carlkesselman/XLeRobot/config/RUNNING.md

# Running the robot

Day-to-day operation. `ORIN-SETUP.md` is the one-time bring-up; this is what
you do every session.

---

## At a glance

| where | what | why first |
|---|---|---|
| **Mac** | `./config/viewer.sh` | the cart connects *out* to it; nothing listening means it back-pressures into the control loop |
| **rosie** | `./config/operator-leader-host.sh` | the cart waits 10 s for the first action and gives up |
| **elroy** | `./config/cart-teleop.sh` or `cart-record.sh` | needs both of the above |

All over SSH. Neither robot machine needs a screen — the Mac is the screen,
and the video originates on the cart, not the Pi.

---

## 1. Mac — the viewer (only if you want video)

```bash
cd ~/GitHub/Robots/XLeRobot        # the Mac's checkout; elroy and rosie
./config/viewer.sh                 # use ~/GitHub/XLeRobot
```

That reads the version out of `uv.lock` and launches it. Don't type the
version yourself and don't leave it off: `uvx --from rerun-sdk rerun` means
"PyPI's latest today", elroy means "whatever the lock says", and those are
currently five minor releases apart. A viewer and an SDK are two halves of
one rerun release — mismatch them and the window opens, sits on the welcome
screen, and never tells you why.

<details>
<summary>the equivalent by hand</summary>

```bash
uvx --from rerun-sdk==0.33.1 rerun     # version must match uv.lock
```

**No flags.** That one process is both the window and the listener — it
opens the viewer *and* serves gRPC on `0.0.0.0:9876`, which is what elroy
connects out to. There is no separate server to start, and `--port 9876`
is just the default spelled out.

It prints this on startup, and it is **not** a sign anything is wrong:

```
INFO re_grpc_server: Listening for gRPC connections on 0.0.0.0:9876.
Connect by running `rerun --connect rerun+http://127.0.0.1:9876/proxy`
```

Every mode that starts the server prints it, window or no window. It is
advice for the case where you *also* want a second viewer attached from
somewhere else — not an instruction to go and run something. Ignore it.
(`--serve-grpc` is the genuinely headless mode. You will not need it.)

</details>

**If the window opens but stays on the welcome screen**, the stream is not
arriving. Prove the link on its own, from elroy, with no robot in the way:

```bash
./config/video.sh synthetic          # moving test pattern, 3 fake cameras
```

Nothing appears? Then it is the link, in this order:

1. the viewer's version matches `uv.lock` — use `./config/viewer.sh`
2. the viewer is running as plain `rerun`, not `--serve-grpc`
3. `nc -z -v 192.168.1.52 9876` from elroy answers
4. the Mac's firewall — System Settings → Network → Firewall. It blocks
   incoming connections to unknown binaries by default, and a
   `uvx`-launched rerun looks like a new binary whenever the cache moves.
   Either allow it when macOS asks, or turn the firewall off long enough
   to find out whether that is the answer.

Skip this whole step if you don't need to see what the robot sees.

---

## 2. rosie — the leaders

```bash
tmux new -s leaders                 # see below
cd ~/GitHub/XLeRobot
./config/operator-leader-host.sh
```

Expect:

```
serving: tcp://192.168.1.100:5557
         remap_arm_prefix: true
         emit_head: true
         emit_base: true
         ^ these must match the cart's config. A mismatch is silent.
Publishing on tcp://*:5557 at 60 Hz
17 action keys:
  ...
```

**17 keys** means arms, head and base. 12 means the head and base are
switched off and the gamepad will do nothing.

**Use tmux.** An SSH drop kills this process, and mid-recording that means
the cart's link stalls, the base zeroes and you lose the take. `Ctrl-B` then
`D` detaches; `tmux attach -t leaders` comes back.

---

## 3. elroy — the robot

```bash
cd ~/GitHub/XLeRobot
./config/cart-teleop.sh            # drive, record nothing; video to the Mac if viewer.sh is running
./config/cart-teleop.sh --watch    # video, warn if the viewer is not up
./config/cart-teleop.sh --no-watch # no video
```

Press ENTER at the calibration prompt to restore from file.

**Hold the leaders roughly where the followers are sitting before you
start.** The first action moves the followers to meet them.

**Cart on blocks** unless you mean it — the base is live.

### Which base

The cart runs in three configurations. One field in the robot config picks
it, and `BASE=` on any cart script overrides it for a run — no yaml edit:

| | `BASE=` | what it means |
|---|---|---|
| two brushless wheels on the ODESC (default) | `odrive` | wheels over USB; bus 2 is the right arm only; features `x.vel`, `theta.vel` |
| the stock three servo omniwheels | `omniwheels` | ids 7–9 on bus 2; features `x.vel`, `y.vel`, `theta.vel` |
| arms and head only | `none` | no wheel ids, no `.vel` features; base commands from the operator are ignored (one warning) |

```bash
BASE=none ./config/cart-teleop.sh                # arms and head, cart parked
BASE=omniwheels ./config/cart-selftest.sh --base
```

The dataset's columns follow the choice, so episodes recorded under
different bases are different datasets. On the operator side `emit_y_vel`
should be true only with `omniwheels`; the others drop a `y.vel` with one
warning rather than fail.

### Recording

```bash
./config/cart-record.sh carlkesselman/<name> "<task description>" \
  --dataset.num_episodes=5 --dataset.episode_time_s=30
```

Episode keys are read by whichever process owns the TTY: right arrow ends an
episode, left re-records it, escape stops. Run it from an SSH session you
are attached to, inside tmux if you like — lerobot falls back to a terminal
listener when pynput cannot capture, so an SSH TTY works.

The script records **locally** (`PUSH_TO_HUB=true` to upload; `hf auth login`
once first), encodes **h264** (`VCODEC=` to change; lerobot's AV1 default is
slow on the Orin), writes frames in 2 processes, and turns lerobot's spoken
prompts off. Datasets land in `~/.cache/huggingface/lerobot/<repo_id>_YYYYMMDD_HHMMSS` - lerobot stamps every new one - and the script prints the path at the end. **Escape saves the current episode and stops; Ctrl-C loses it.** The
Jetson needs the `dataset` extra, which `./config/sync.sh` adds and checks.

The shared yaml's top-level `fps:` is a teleop field that `lerobot-record`
rejects; the script records from a copy without it, so the yaml stays
shared. The head camera is RGB now, like the wrists (it was BGR).

### Training

```bash
./config/cart-train.sh carlkesselman/<name>
```

From elroy, where the recording is. A plain name picks the newest
`<name>_<date>_<time>`; lerobot pushes it to a **private** Hub repo if it is
not there yet, then submits ACT to Hugging Face Jobs (`FLAVOR=a10g-small`,
`STEPS=100000`). The model lands at `carlkesselman/act_<name>`. Needs
`hf auth login` and an HF account that can run Jobs. Run it in tmux: the log
streams here, and an SSH drop ends the stream but not the job
(`hf jobs logs <id>` picks it up again).

### Running a policy

```bash
BASE=none ./config/cart-eval.sh carlkesselman/act_<name> "<task description>"
BASE=none ./config/cart-eval.sh --record carlkesselman/act_<name> "<task description>"
```

**The policy drives the arms.** Use the same `BASE=` and the same task text
as the recording. The first form runs for 60 s (`DURATION=`) and records
nothing. `--record` runs 10 scored episodes into
`carlkesselman/eval_act_<name>_<date>_<time>`, with the same episode keys as
recording. rosie is not needed: between episodes the arms go back to their
startup pose. `--leaders` connects to rosie instead, so the operator can
reset the arms between episodes.

---

## Controls

8BitDo SF30 Pro, wired, in its PlayStation-compatible mode.

| control | does |
|---|---|
| leader arms | the follower arms |
| D-pad | head pan / tilt |
| left stick Y | base forward/back (no strafe: the ODrive base is a differential drive) |
| right stick X | base turn |
| R1 / L2 | base speed up / down |

If the pad power-cycles into a different input mode every one of those
becomes wrong at once, and the symptom is a cart that drives sideways rather
than any error. Re-probe:

```bash
uv run python -m \
  lerobot_teleoperator_xlerobot_leader_gamepad.probe_gamepad
```

---

## What good looks like

From the cadence summary printed on Ctrl-C:

```
effective cadence  29.5 Hz    (target 30 - the camera frame rate is the ceiling)
observe            ~28 ms     95% of all work; it is waiting for frames, not computing
teleop             0.05 ms    the whole network leader
send               ~1.5 ms
pacing headroom    4.3 ms     without video, 1.6 ms with
```

**Headroom is the number to watch.** Near zero means the loop is saturated
and has nothing left to absorb a hiccup. Video costs about 2.7 ms of it.

30 Hz is the ceiling, not a disappointment: `observe` blocks until the next
camera frame, and the cameras are 30 fps. A 4x reduction in pixels bought
only 13% off it, which is how we know it is latency-bound rather than
pixel-bound.

---

## When it goes wrong

| symptom | cause |
|---|---|
| **Arms do not move, loop runs at rate, no errors** | `remap_arm_prefix` disagrees across the link. `bi_so_follower` strips `left_`; `xlerobot` filters on `left_arm_`. |
| **Gamepad does nothing** | `emit_head`/`emit_base` false on rosie. Check the 17-key count. |
| `No action from the leader host ... within 10.0s` | leader host not running, or the wrong IP in `cart-remote.yaml` |
| `Leader link stalled` | wifi. Arms hold, base zeroes. Occasional is normal; constant is not. |
| `Failed to write 'Torque_Enable' on id_=N` | a dropped packet; `configure()` retries three times now. If it persists, run `./config/servo.sh power` before suspecting a servo. |
| `Failed to open OpenCVCamera(/dev/cam_left)` | usually a stale process: `pkill -f lerobot-teleoperate`. If the symlink is missing instead, `sudo udevadm trigger --action=add --subsystem-match=video4linux`. |
| **Script prints the header and exits silently** | `set -e` on a non-zero return. Shout about it; it is a bug. |
| **A fresh calibration starts** | you are on the arms-only config without one. It should refuse now — if it does not, Ctrl-C before the range-recording phase or you lose `robots/xlerobot/xlerobot.json`. |
| **CPU torch on elroy** | a bare `uv sync`. Use `./config/sync.sh`, which picks the right extras per machine. |
| **`Leader link stalled ... base stopped, arms holding` about once a second, only with `--watch`** | the cart's TCP ACKs to rosie queued behind video on the wifi uplink. Both sockets now set `TOS 0xC0` (voice queue) — see `link.py`. If it persists: `iperf3 -c 192.168.1.52` from elroy for the real uplink goodput, and cap the send buffer so back-pressure reaches rerun instead of the kernel: `sudo sysctl -w net.ipv4.tcp_wmem='4096 16384 262144'` (not persistent; put it in `/etc/sysctl.d/` if it helps). The stall line now prints sequence gaps, and recovery prints apparent one-way delay. |
| **Video many seconds behind on every camera, and `Leader link stalled` every second or so** | wifi power saving on elroy or rosie. `iw dev <iface> get power_save` (`/usr/sbin/iw` on rosie); if `on`, see "Wifi power saving off" in `ORIN-SETUP.md`. On elroy also `cat /sys/module/rtl8822ce/parameters/rtw_power_mgnt` - the driver's own power saving, which `iw` does not show; it must be `0`. Then `iperf3 -c 192.168.1.52` from elroy, with `iperf3 -s` on the Mac, for what the link really carries. |
| **Picture seconds behind, loop healthy** | same queue as the row above. Frames are now stamped with capture time, so the lag shows as an offset in the viewer's timeline rather than looking fresh. `LEROBOT_RERUN_JPEG_QUALITY` (default 70) and `LEROBOT_RERUN_IMAGE_FPS` (default 10) are the two levers; `tcp_wmem` above is the third. |
| **Head jerky, arms smooth** | `head_goal_velocity` / `head_acceleration` in the robot config give the head servos a motion profile; defaults 600 / 40. Lower acceleration = smoother, slower to start. |
| **Viewer draws the grid, then stops responding as soon as frames arrive** | `rerun_visualization.py` logging images with `static=True`. Fixed here — but it is upstream's file, so a merge from upstream will bring it back. One 160x120 frame a second is enough to trigger it, so do not read it as a bandwidth problem. `./config/video.sh synthetic --no-static` is the control. |

---

## Diagnostics

Grouped by what they look at. Each multi-command script prints its own
list with `--help`.

| | |
|---|---|
| **the cart** | |
| `./config/cart-selftest.sh` | the cart alone: rate, joint values, a frame per camera. `--head --arms --base` to move things; `BASE=none` without wheels. |
| **servos** - `./config/servo.sh` | |
| `servo.sh scan` | which ids answer on each bus, at which baud rate |
| `servo.sh power` | voltage, temperature and load per servo, torque on one at a time |
| `servo.sh regs [--bus 1]` | every config and status register side by side; flags the servo that differs or runs hot. For one that answers a scan but will not move. Read-only. |
| `servo.sh set-id --bus N --id M [--port ...]` | give a replacement servo its id. It must be the only servo on that bus board (it refuses otherwise); any board works, rosie's included. |
| `servo.sh recal <joint>` | recalibrate one joint after a swap (homing offset + range), leaving the other thirteen. Backs up the calibration file first. |
| **cameras and video** - `./config/video.sh` | |
| `video.sh probe /dev/cam_left [--buffersize 2]` | how many stale frames the driver hands back after a pause |
| `video.sh view` | the real cameras to the viewer, no motor bus touched (arms may be off). Loop rate and display cost, PASS/FAIL; `--help` for the glass-to-glass lag test with `python3 config/ms_clock.py` on the Mac. |
| `video.sh synthetic` | a generated feed to the viewer: the network and viewer with the cameras taken out |
| `./config/viewer.sh` | the rerun viewer, at the version uv.lock says. On the Mac. |
| **leader link** - `./config/leader-link.sh` | |
| `leader-link.sh tap` | the leader stream with no robot: which keys ever changed |
| `leader-link.sh soak [--minutes 5]` | the link for N minutes, graded: stalls, lost messages, histogram. Run quiet, then with `video.sh synthetic` going; both must PASS. |
| **data** | |
| `./config/dataset-check.sh <repo_id>` | read a recording back: frames, features, a decoded frame per camera as PNG, video files. Picks the newest `<repo_id>_<date>_<time>`. |
| **base** | |
| `./config/odrive-check.sh` | the ODESC: config vs the bus limits, `--apply` to write them, `--watch` through a power cut. Motor bring-up: `--halls` (pole pairs), `--setup-motors`, `--calibrate` (drill pack, wheels up), `--spin --axis N`. Tuning: `--push` (floor, which limit stops it), `--save-gains`. |
| `./config/base-characterize.sh` | the base from first principles: `blocks` (motor constant, wheel inertia), `floor` (breakaway, cart inertia, friction vs speed), `design` (current limit, gains, feed-forward, limits - with reasons), `step --candidates` (validate through the teleop code path, pick). |
| **environment** | |
| `./config/sync.sh` | sync with the right extras for this machine |

---

## Order matters

Viewer, then leaders, then cart. Each waits on the one before:

- the cart gives up after 10 s with no leader host
- rerun's proxy may not replay what it buffered before a viewer attached
- starting the cart first just means doing it again
