carlkesselman/XLeRobot/hardware/lidar_bracket/ld19_basket_mount_upper.step

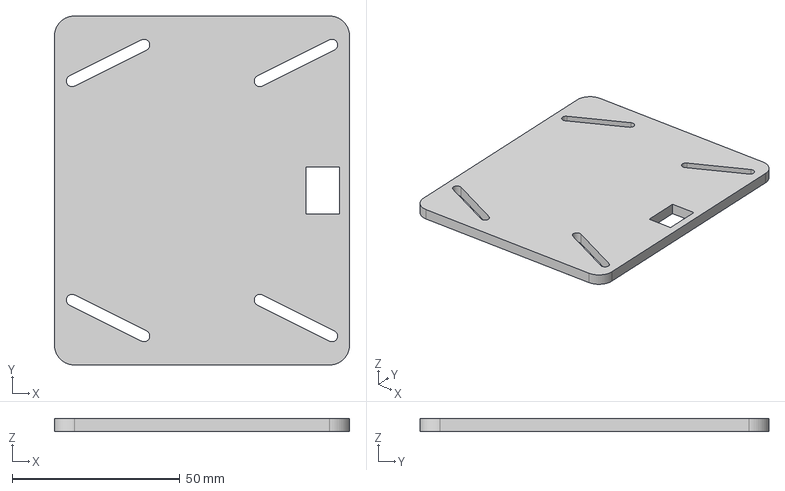
[picture p2: CAD file, 2026-11-03]
hardware/lidar_bracket/ld19_basket_mount_upper.step
88.0 x 104.0 x 4.00 mm
