carlkesselman/XLeRobot/simulation/xlerobot/meshes/xlerobot/assets/Lower_Arm.stl

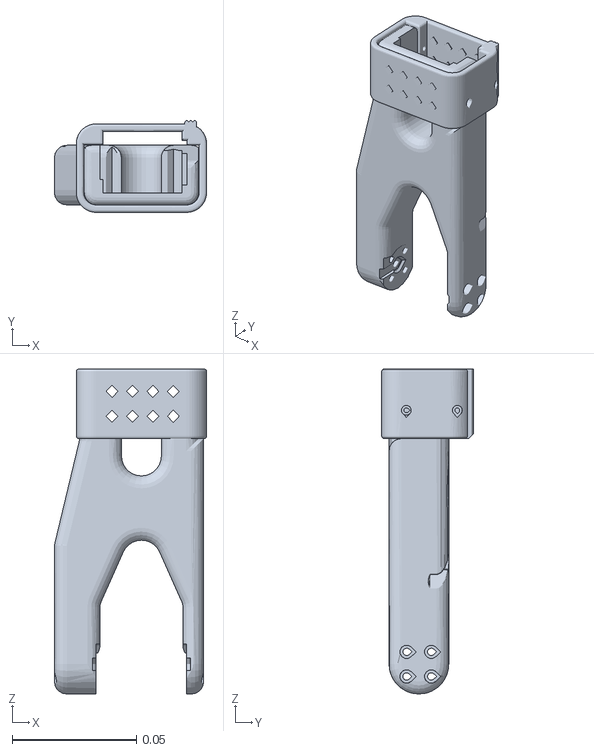
[picture p3: CAD file, 2026-10-06]
simulation/xlerobot/meshes/xlerobot/assets/Lower_Arm.stl
0.0612 x 0.0369 x 0.131
