carlkesselman/XLeRobot/hardware/lidar_bracket/ld19_basket_mount_lower.step

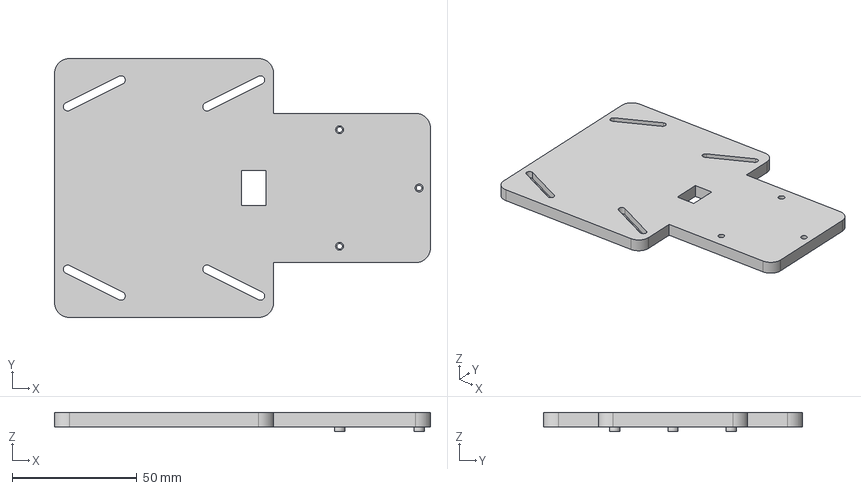
[picture p4: CAD file, 2026-11-03]
hardware/lidar_bracket/ld19_basket_mount_lower.step
151.0 x 104.0 x 7.80 mm
