carlkesselman/XLeRobot/simulation/xlerobot/meshes/xlerobot/assets/topbase2.stl

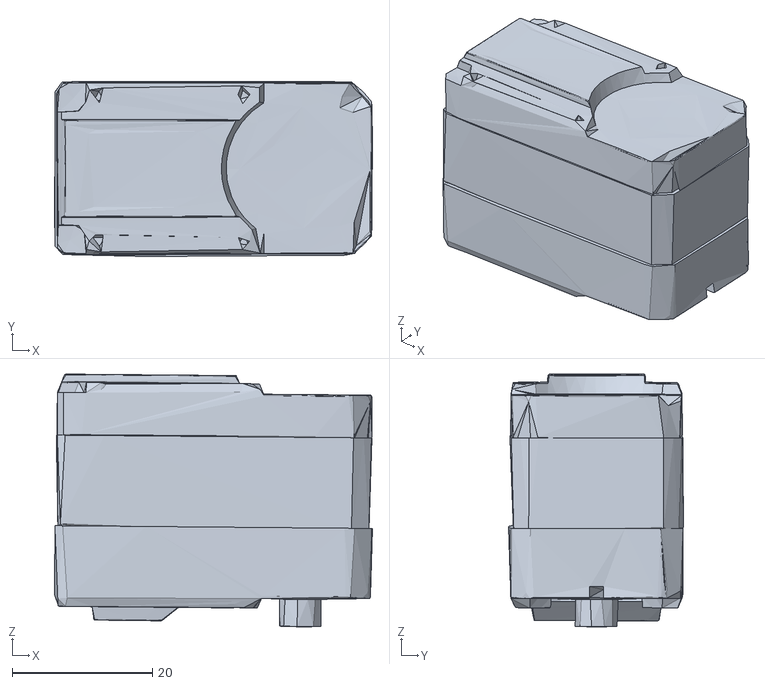
[picture p5: CAD file, 2026-10-06]
simulation/xlerobot/meshes/xlerobot/assets/topbase2.stl
45.3 x 24.9 x 36.0
