carlkesselman/XLeRobot/simulation/xlerobot/meshes/xlerobot/assets/Fixed_Jaw.stl

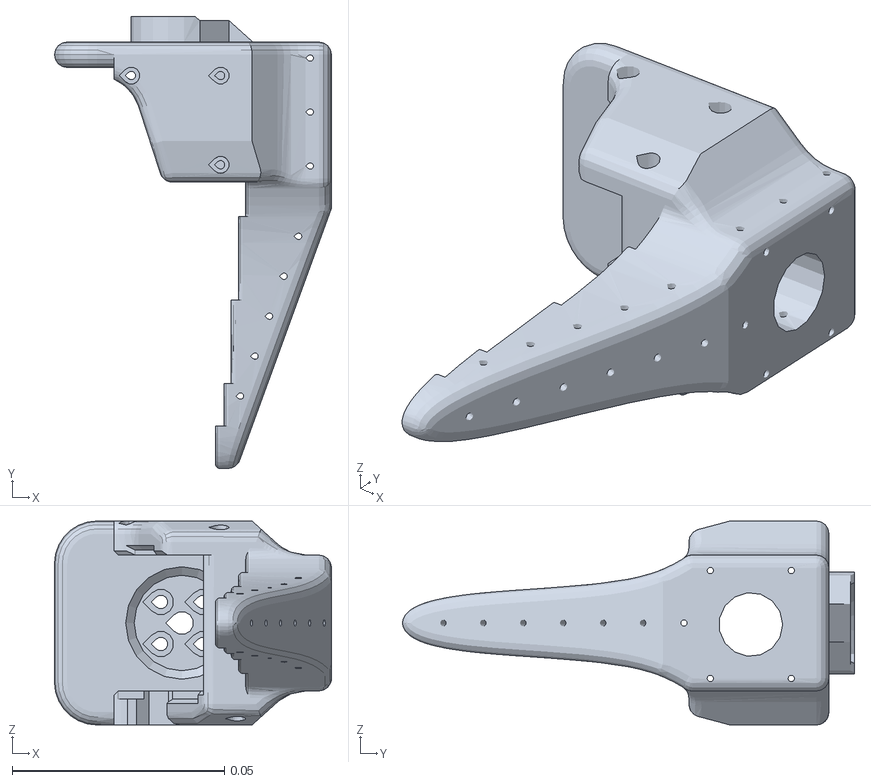
[picture p6: CAD file, 2026-10-06]
simulation/xlerobot/meshes/xlerobot/assets/Fixed_Jaw.stl
0.0652 x 0.106 x 0.048
