carlkesselman/XLeRobot/simulation/xlerobot/meshes/xlerobot/assets/Upper_Arm_Motor.stl

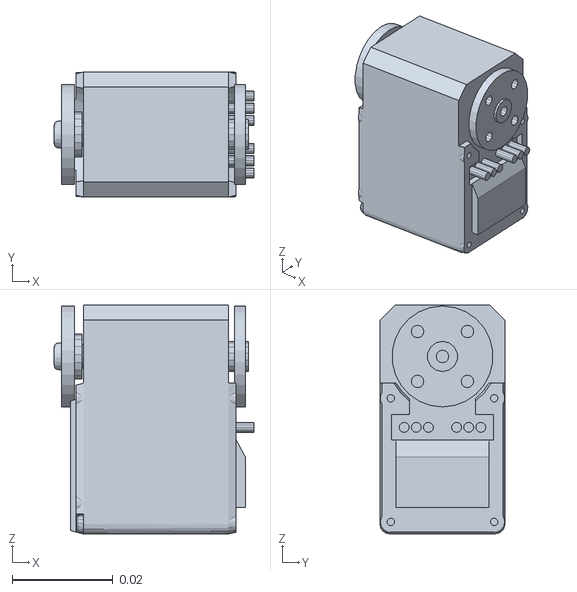
[picture p7: CAD file, 2026-10-06]
simulation/xlerobot/meshes/xlerobot/assets/Upper_Arm_Motor.stl
0.0396 x 0.0248 x 0.0454
