carlkesselman/XLeRobot/simulation/xlerobot/meshes/xlerobot/assets/raskogwheel1.stl

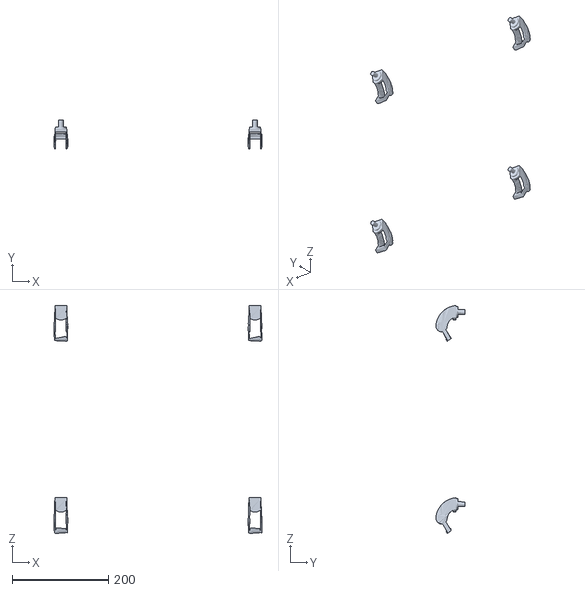
[picture p8: CAD file, 2026-10-06]
simulation/xlerobot/meshes/xlerobot/assets/raskogwheel1.stl
432.7 x 61.2 x 474.6
