carlkesselman/XLeRobot/simulation/xlerobot/meshes/xlerobot/assets/XLeRobot_camera1.stl

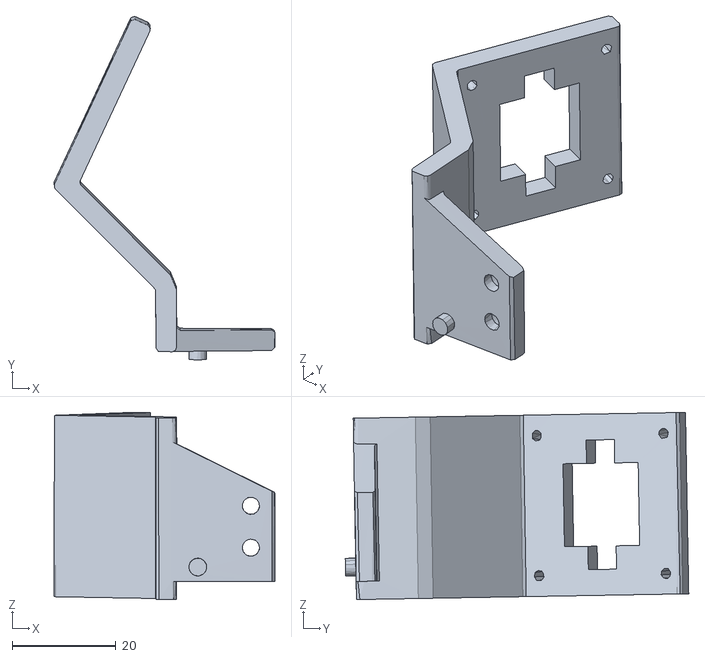
[picture p9: CAD file, 2026-10-06]
simulation/xlerobot/meshes/xlerobot/assets/XLeRobot_camera1.stl
42.6 x 66.3 x 36.1
