carlkesselman/XLeRobot/simulation/xlerobot/meshes/xlerobot/assets/Moving_Jaw.stl

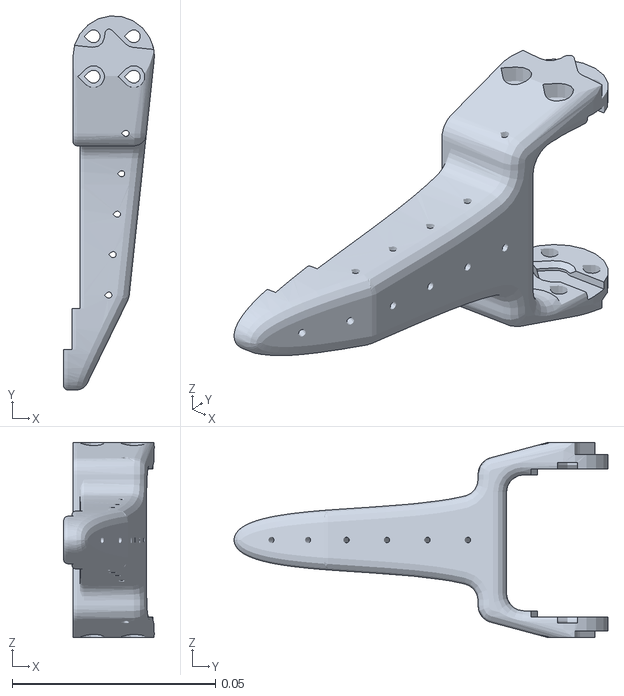
[picture p10: CAD file, 2026-10-06]
simulation/xlerobot/meshes/xlerobot/assets/Moving_Jaw.stl
0.0223 x 0.092 x 0.048
