carlkesselman/XLeRobot/simulation/xlerobot/meshes/xlerobot/assets/raskogwheel2.stl

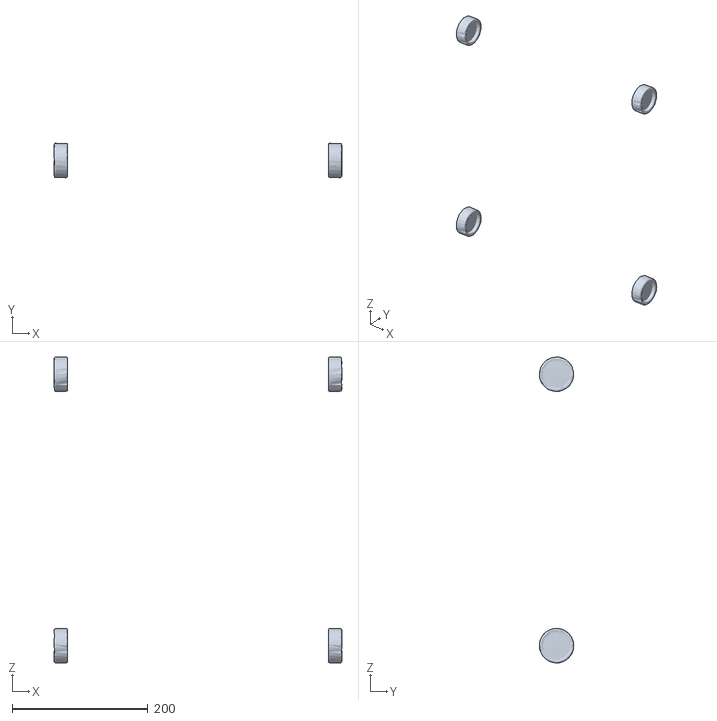
[picture p11: CAD file, 2026-10-06]
simulation/xlerobot/meshes/xlerobot/assets/raskogwheel2.stl
424.1 x 50.9 x 450.9
