carlkesselman/XLeRobot/simulation/xlerobot/meshes/xlerobot/assets/Wrist_Pitch_Roll_Motor.stl

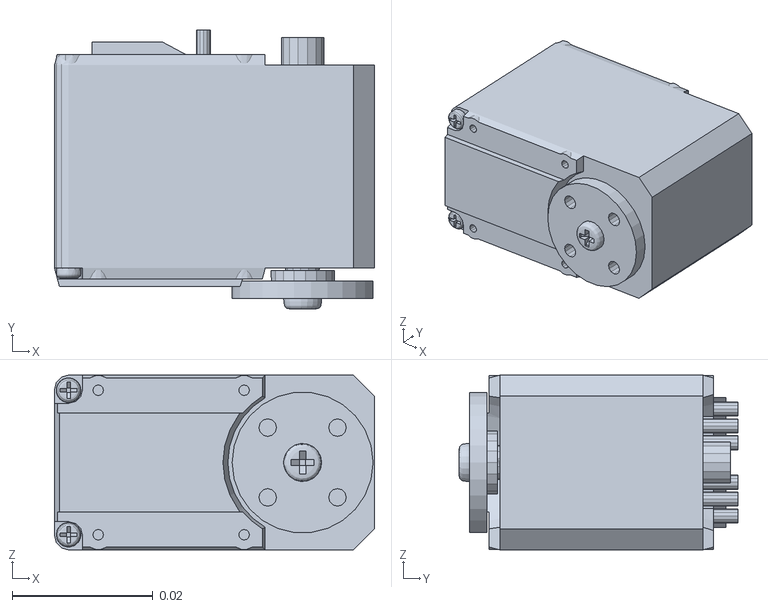
[picture p12: CAD file, 2026-10-06]
simulation/xlerobot/meshes/xlerobot/assets/Wrist_Pitch_Roll_Motor.stl
0.0454 x 0.0396 x 0.0248
