carlkesselman/XLeRobot/simulation/xlerobot/meshes/xlerobot/assets/tophead6.stl

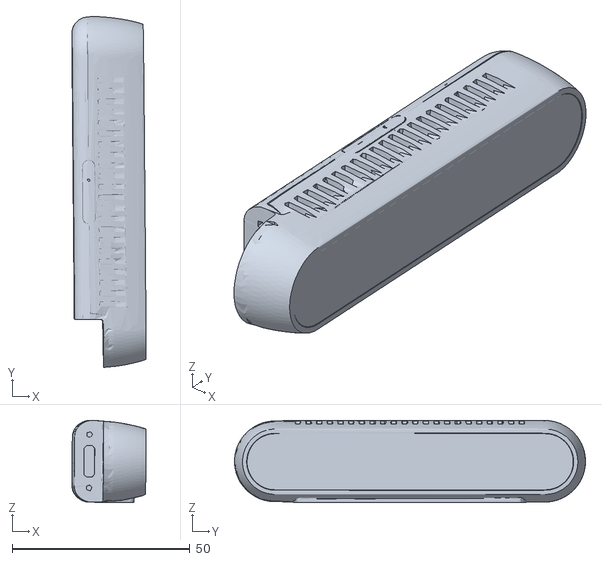
[picture p13: CAD file, 2026-10-06]
simulation/xlerobot/meshes/xlerobot/assets/tophead6.stl
20.9 x 98.8 x 23.1
