carlkesselman/XLeRobot/simulation/xlerobot/meshes/xlerobot/assets/Wrist_Pitch_Roll.stl

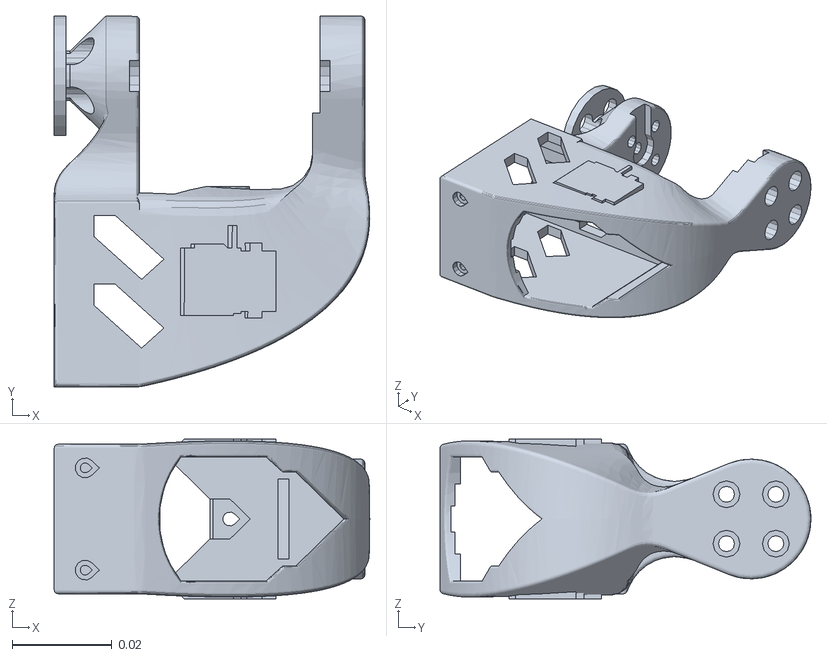
[picture p14: CAD file, 2026-10-06]
simulation/xlerobot/meshes/xlerobot/assets/Wrist_Pitch_Roll.stl
0.0633 x 0.0744 x 0.032
