carlkesselman/XLeRobot/simulation/xlerobot/meshes/xlerobot/assets/topbase1.stl

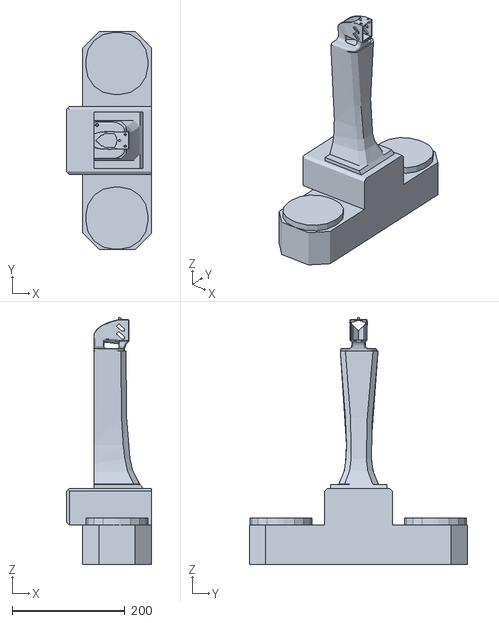
[picture p15: CAD file, 2026-10-06]
simulation/xlerobot/meshes/xlerobot/assets/topbase1.stl
150.4 x 386.3 x 437.4
