carlkesselman/XLeRobot/simulation/xlerobot/meshes/xlerobot/assets/Fixed_Jaw_part1.ply.convex.stl

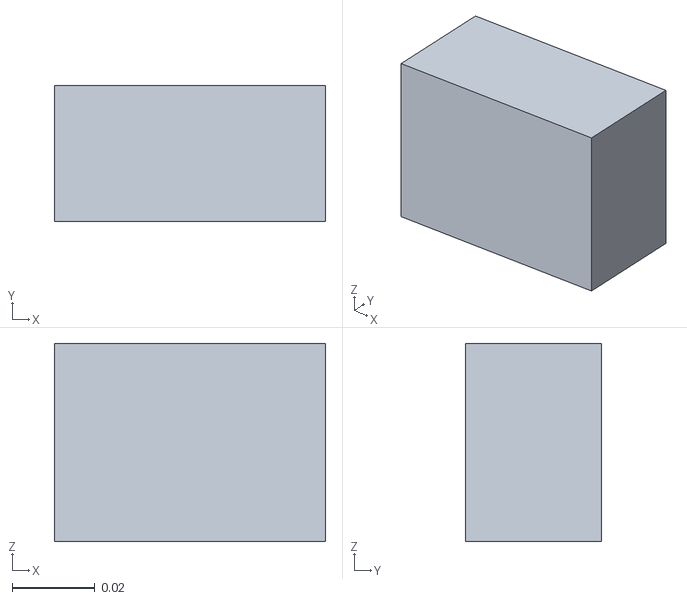
[picture p16: CAD file, 2026-10-06]
simulation/xlerobot/meshes/xlerobot/assets/Fixed_Jaw_part1.ply.convex.stl
0.0656 x 0.0328 x 0.048
