carlkesselman/XLeRobot/simulation/xlerobot/meshes/xlerobot/assets/XLeRobot_camera2.stl

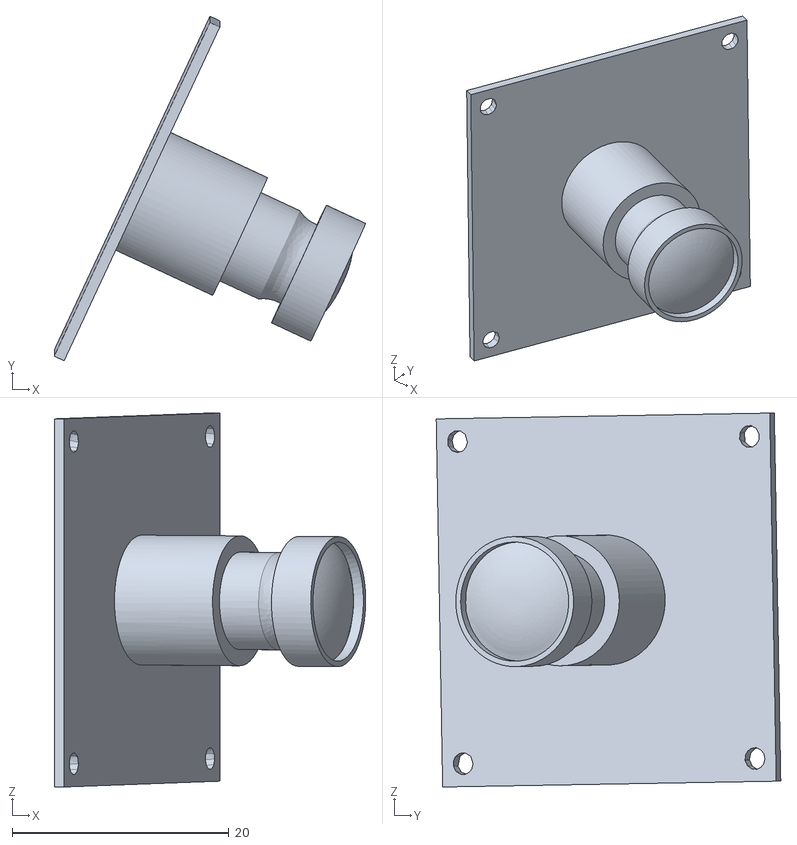
[picture p17: CAD file, 2026-10-06]
simulation/xlerobot/meshes/xlerobot/assets/XLeRobot_camera2.stl
28.8 x 31.8 x 34.5
