carlkesselman/XLeRobot/simulation/xlerobot/meshes/xlerobot/assets/Upper_Arm.stl

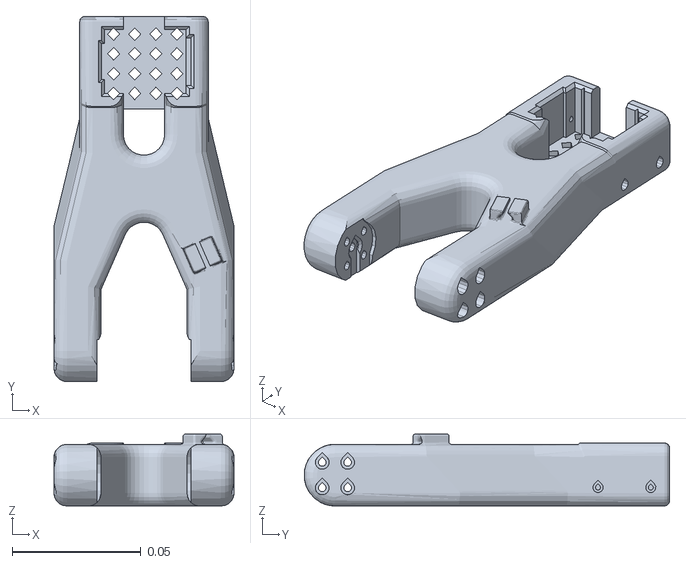
[picture p18: CAD file, 2026-10-06]
simulation/xlerobot/meshes/xlerobot/assets/Upper_Arm.stl
0.07 x 0.142 x 0.028
