carlkesselman/XLeRobot/simulation/xlerobot/meshes/xlerobot/assets/Fixed_Jaw_part2.ply.convex.stl

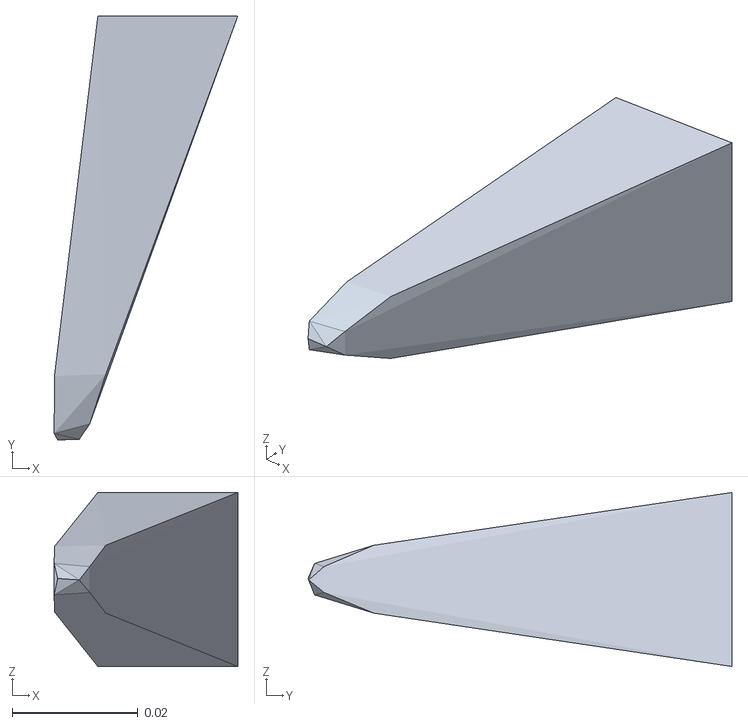
[picture p19: CAD file, 2026-10-06]
simulation/xlerobot/meshes/xlerobot/assets/Fixed_Jaw_part2.ply.convex.stl
0.0292 x 0.0675 x 0.0277
