carlkesselman/XLeRobot/simulation/xlerobot/meshes/xlerobot/assets/Moving_Jaw_part1.ply.convex.stl

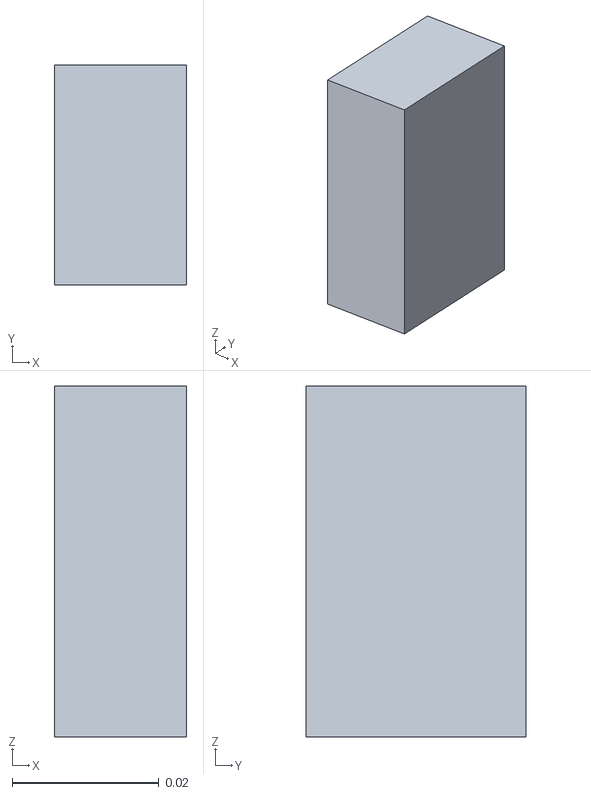
[picture p20: CAD file, 2026-10-06]
simulation/xlerobot/meshes/xlerobot/assets/Moving_Jaw_part1.ply.convex.stl
0.018 x 0.03 x 0.0478
