carlkesselman/XLeRobot/simulation/xlerobot/meshes/xlerobot/assets/tophead5.stl

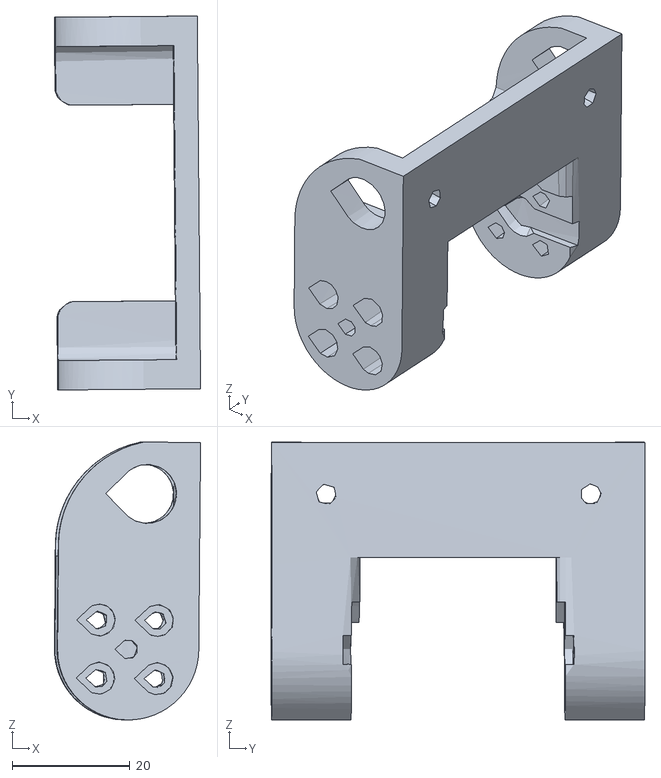
[picture p21: CAD file, 2026-10-06]
simulation/xlerobot/meshes/xlerobot/assets/tophead5.stl
24.9 x 63.6 x 47.3
