carlkesselman/XLeRobot/simulation/xlerobot/meshes/xlerobot/assets/raskogbody.stl

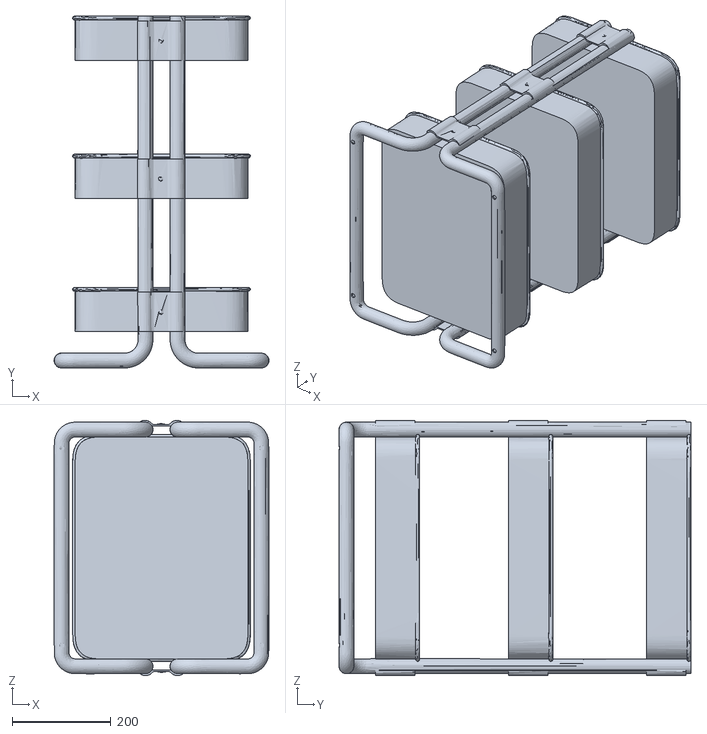
[picture p22: CAD file, 2026-10-06]
simulation/xlerobot/meshes/xlerobot/assets/raskogbody.stl
435.9 x 713.7 x 517.9
