carlkesselman/XLeRobot/simulation/xlerobot/meshes/xlerobot/assets/Base.stl

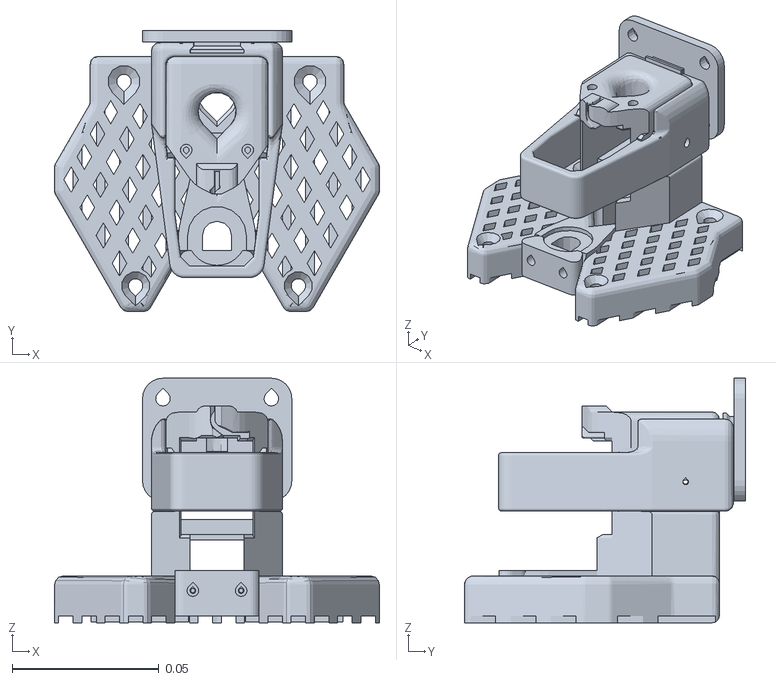
[picture p23: CAD file, 2026-10-06]
simulation/xlerobot/meshes/xlerobot/assets/Base.stl
0.111 x 0.0959 x 0.0835
