carlkesselman/XLeRobot/simulation/xlerobot/meshes/xlerobot/assets/Rotation_Pitch.stl

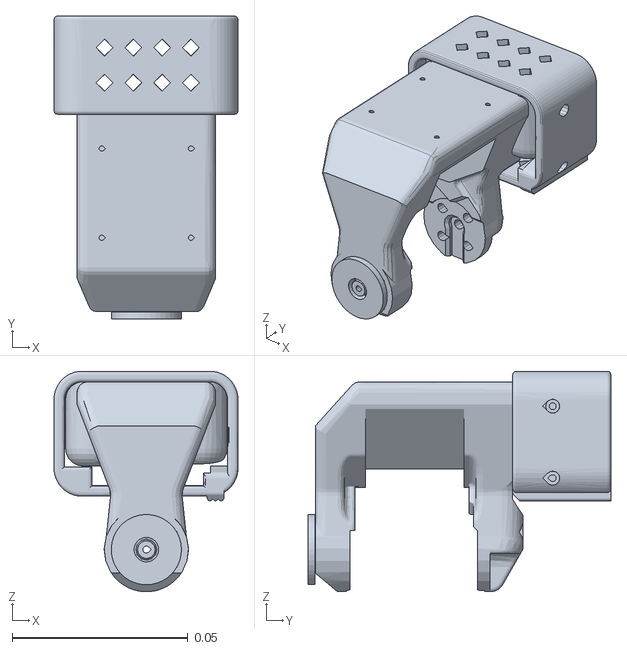
[picture p24: CAD file, 2026-10-06]
simulation/xlerobot/meshes/xlerobot/assets/Rotation_Pitch.stl
0.0524 x 0.0863 x 0.0628
