carlkesselman/XLeRobot/simulation/xlerobot/meshes/xlerobot/assets/Moving_Jaw_part2.ply.convex.stl

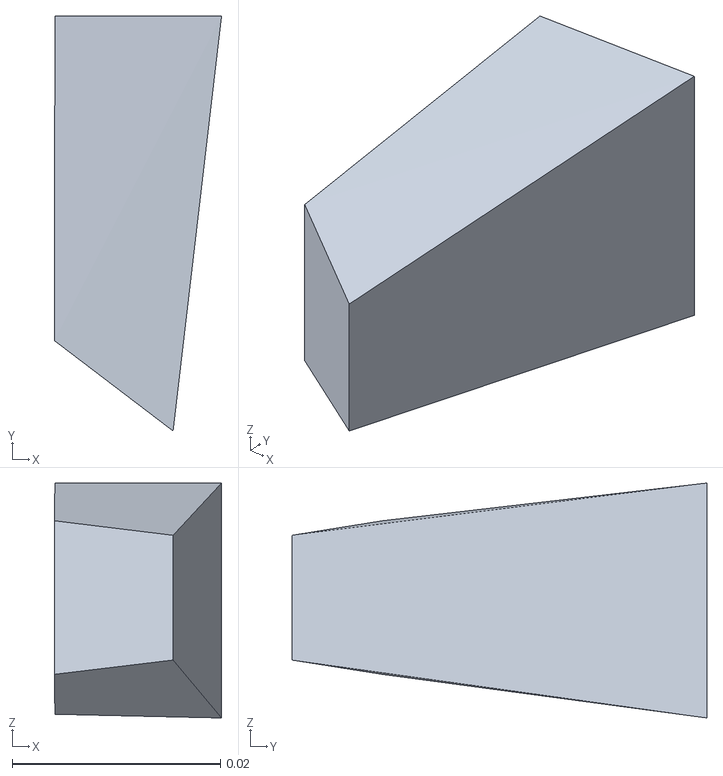
[picture p25: CAD file, 2026-10-06]
simulation/xlerobot/meshes/xlerobot/assets/Moving_Jaw_part2.ply.convex.stl
0.0161 x 0.0399 x 0.0226
