carlkesselman/XLeRobot/simulation/xlerobot/meshes/xlerobot/assets/Moving_Jaw_part3.ply.convex.stl

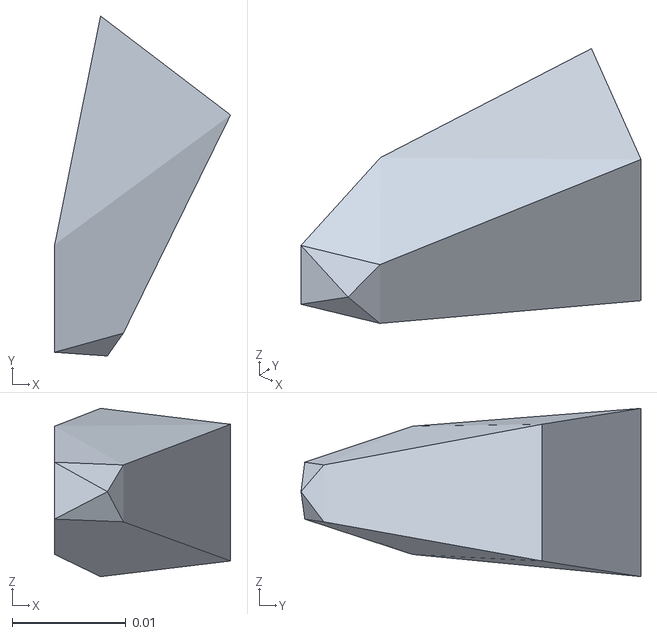
[picture p26: CAD file, 2026-10-06]
simulation/xlerobot/meshes/xlerobot/assets/Moving_Jaw_part3.ply.convex.stl
0.0155 x 0.0298 x 0.0148
