carlkesselman/XLeRobot/simulation/xlerobot/meshes/xlerobot/assets/tophead1.stl

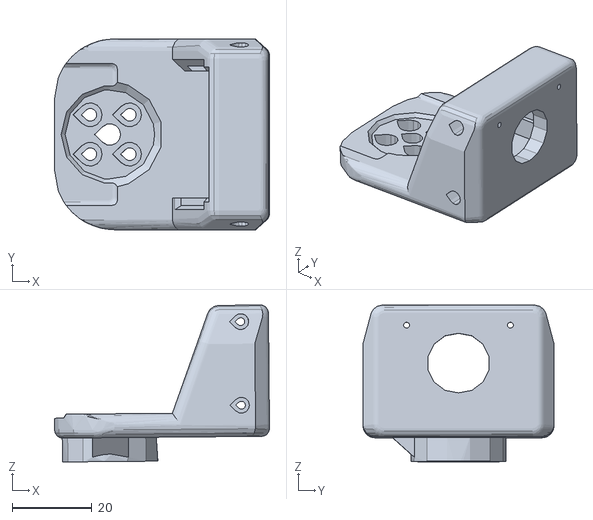
[picture p27: CAD file, 2026-10-06]
simulation/xlerobot/meshes/xlerobot/assets/tophead1.stl
54.0 x 48.0 x 39.4
