carlkesselman/XLeRobot/(list of files, cad)

Other CAD files:
simulation/xlerobot/meshes/xlerobot/assets/Fixed_Jaw_Motor.stl
simulation/xlerobot/meshes/xlerobot/assets/Rotation_Pitch_Motor.stl
simulation/xlerobot/meshes/xlerobot/assets/Lower_Arm_Motor.stl
simulation/xlerobot/meshes/xlerobot/assets/tophead4.stl
simulation/xlerobot/meshes/xlerobot/assets/Base_Motor.stl
hardware/lidar_bracket/ld19_basket_mount_lower.stl
hardware/lidar_bracket/ld19_basket_mount_upper.stl
