carlkesselman/XLeRobot/config/ORIN-SETUP.md

# Bringing up elroy (the Orin) as the cart

One step at a time, each with a check that has to pass before the next.
Everything here runs on the Orin unless a step says otherwise.

The aim of this document is a verified robot on one machine — arms, head,
base and three cameras — with no network, no leader arms and no dataset in
the picture. Those come after.

---

## 0. Find out what hardware you actually have

**Run this where the arms are plugged in right now** — on the Pi, before
moving anything. It is a hardware question, not a machine question, and
knowing the answer changes every later step.

```bash
./config/servo.sh scan
```

It pings every id at every supported baud rate on both buses and maps what
answers onto the xlerobot layout:

```
bus1   1-6 left arm    7-8 head
bus2   1-6 right arm   7-9 base wheels
```

The three outcomes:

- **Arms, head and base all present** → the full `xlerobot` path works.
  Continue through this document as written.
- **Arms only, head missing** → the robot fails on connect: it reads the
  head on the same bus as the left arm, so a missing head servo stops the
  arms too. Wire it before going on. (A missing *base* is fine:
  `BASE=none` runs arms and head alone.)
- **Something at the wrong baud rate** → `lerobot-setup-motors` for those
  servos. lerobot talks at 1000000 and will not find them otherwise.

A whole bus silent is usually the cable or the power. One id silent is
usually that servo or the daisy-chain link into it.

---

## 1. Python 3.12 and the workspace

```bash
git clone -b rosie-config     https://github.com/carlkesselman/XLeRobot.git ~/GitHub/XLeRobot
git clone -b feature/xlerobot https://github.com/carlkesselman/lerobot.git  ~/GitHub/lerobot   # sibling

cd ~/GitHub/XLeRobot            # config/ and the workspace both live here
uv python pin 3.12
./config/sync.sh                # not a bare uv sync - see the script
```

**3.12 exactly.** `pyrealsense2` publishes aarch64 wheels for cp39, cp310
and cp312 only — no cp313, no cp314, and no sdist to build from. lerobot
needs ≥3.12, which leaves one version.

**Sync from XLeRobot, never from lerobot.** XLeRobot is the workspace root
and maps `lerobot` to `../lerobot`; syncing from the lerobot repo prunes
the plugins and `--robot.type=xlerobot` stops resolving.

Check:

```bash
uv run python -c "
from lerobot.robots import make_robot_from_config
from lerobot_robot_xlerobot import XLerobotConfig
print('xlerobot plugin OK')"
```

---

## 2. GPU torch

A plain `uv sync` installs PyPI's aarch64 **CPU** torch. That is wrong for
the machine whose entire reason for being on the cart is the GPU, and
nothing will tell you — teleoperation and recording do not care, inference
does.

**On JetPack 7 the Orin uses the stock upstream CUDA wheels.** NVIDIA
confirmed Orin can take the SBSA package, so the old ritual of hunting
NVIDIA forum wheels is over. Note also that the `jetson-ai-lab.io/jp6/cu126`
index does **not** work on JetPack 7 — people try it and get
"from versions: none".

Check what CUDA you actually have, because the index name has to match:

```bash
/usr/local/cuda/bin/nvcc --version | tail -2     # nvcc is not on PATH by default
nvidia-smi | head -4
```

On elroy that reads CUDA **13.2**, driver 595.78 — hence `cu132`. The
XLeRobot workspace declares that as the `jetson` extra, so:

```bash
cd ~/GitHub/XLeRobot
uv sync --extra jetson
```

**Use `./config/sync.sh` instead of `uv sync`.** It detects a Jetson and
adds the extra for you, so the question stops existing:

```bash
./config/sync.sh
```

`uv sync` makes the environment match the lock, so a bare sync on this
machine silently replaces CUDA torch with the CPU build — no error, nothing
downstream fails, and you find out weeks later when inference is slow.

That cannot be prevented in configuration. uv has no environment variable
for extras (`UV_NO_DEFAULT_GROUPS` exists; `UV_EXTRA` does not), and
`tool.uv.default-groups` lives in `pyproject.toml`, which rosie shares — and
the cu132 source marker is `linux aarch64`, which matches rosie too, so
making it a default would push CUDA torch onto the Pi.

So instead: one command that is always right, plus a check in `_common.sh`
that every cart script runs. If a bare `uv sync` ever does happen, the next
`cart-teleop.sh`, `cart-record.sh` or `cart-selftest.sh` says so in a banner
rather than carrying on quietly.

Why an extra rather than a platform marker: rosie is `aarch64 linux` too.
No environment marker distinguishes a Jetson from a Raspberry Pi, so nothing
uv can evaluate on its own will do it. The extra is the only lever.

Verify:

```bash
uv run python -c "
import torch
print(torch.__version__)
print('cuda available:', torch.cuda.is_available())
print('device:', torch.cuda.get_device_name(0) if torch.cuda.is_available() else '-')
x = torch.randn(1000, 1000, device='cuda') @ torch.randn(1000, 1000, device='cuda')
print('matmul on', x.device, 'ok')"
```

`+cu132` in the version and `cuda available: True`. If it says `True` but the
version has no `+cu`, you are on a CPU build that found a GPU it cannot use.

You may see a compute-capability warning; NVIDIA says the PyTorch team is
removing it.

---

## 3. Move the hardware

From the Pi to the Orin: both follower arm buses, both wrist cameras, the
head RealSense. **The leader arms stay on the Pi** — that is the whole
point of the split.

Give the RealSense a root port of its own. On the Pi, sharing a host
controller with a wrist camera killed that camera's frame reads the moment
the RealSense started streaming (`read failed (status=False)` →
`exceeded maximum consecutive read failures`). The Orin's controller map
differs, but the contention does not care:

```bash
lsusb -t          # 5000M = USB 3, 480M = USB 2
```

Check the serial buses came up:

```bash
ls -l /dev/serial/by-id/
```

Expect four entries while the leaders are still attached, two after they
move to the Pi:

| serial | role |
|---|---|
| `5A7A058116` | left follower → port1 |
| `5B91028673` | right follower → port2 |

---

## 4. Camera names

The configs use `/dev/cam_left` and `/dev/cam_right`, so the physical port
lives in one udev rule instead of three config files.

**Measured on elroy, 2026-10-22** — both wrist cameras on the external hub
(re-measured after the base wiring; on 2026-10-09 they were `2.3.3` / `2.3.4`
and the RealSense `1.1`):

| | ID_PATH | node |
|---|---|---|
| left wrist | `platform-3610000.usb-usb-0:2.1.3:1.0` | video2 |
| right wrist | `platform-3610000.usb-usb-0:2.1.1:1.0` | video0 |
| head RealSense | `platform-3610000.usb-usb-0:1.3:1.0` and `:1.3` | video4–9 |

Node numbers follow plug-in order and are not stable; the `cam_*` names are.

`config/99-cameras-elroy.rules` has those baked in:

```bash
sudo cp config/99-cameras-elroy.rules /etc/udev/rules.d/99-cameras.rules
sudo udevadm control --reload-rules
sudo udevadm trigger --action=add --subsystem-match=video4linux
ls -l /dev/cam_*
```

You should see `cam_left` and `cam_right` pointing at the capture node of each
(today `video2` and `video0`; the numbers can change between boots).

**`--action=add` is load-bearing.** Plain `udevadm trigger` fires *change*
events, and these rules do not take effect on a change: you reload, you
trigger, you get no symlink, and nothing anywhere reports an error. The
rules file is correct, the paths are correct, and it simply does not fire.
Unplugging and replugging the camera also works, for the same reason - that
is a genuine add event.

This is worth remembering because the symptom is indistinguishable from a
wrong `ID_PATH`, and you will burn an hour checking paths that were right
all along.

If you ever need to redo this mapping — a new machine, a moved hub — the
reliable method is positional, because both Innomakers report serial
`SN0001` and nothing in their identity tells them apart. Unplug both, plug
in only the left one, and record which capture node appears:

```bash
for d in /dev/video*; do
  echo "$d  $(udevadm info -q property $d | grep -E '^(ID_PATH|ID_V4L_CAPABILITIES)=' | tr '\n' ' ')"
done
```

Two details that are easy to get wrong:

- **Each camera makes two nodes sharing one `ID_PATH`** — a capture node and
  a metadata node. Only the capture one has `:capture:` in
  `ID_V4L_CAPABILITIES`. Without that filter in the rule, the symlink lands
  on whichever node udev handles last, and you get a camera that opens fine
  and never delivers a frame.
- **Use `ENV{ID_PATH}`, not `KERNELS`.** On the Pi a `KERNELS` rule stopped
  working after a camera changed ports and would not come back even once the
  value was corrected — `udevadm test` showed the right value in the device
  chain and created no symlink. Never explained; `ID_PATH` has not done it.

The paths encode the *hub's* ports. Move a camera to a different hub port,
or the hub to a different Type-A port, and the rule silently stops matching.
Check `ls -l /dev/cam_*` after any replug.

### Formats

```bash
v4l2-ctl --device=/dev/cam_left --list-formats-ext
```

```
MJPG  1280x720  30.000 fps
YUYV  1280x720  10.000 fps    <- what OpenCV picks by default
```

Uncompressed 720p30 is ~55 MB/s, past USB 2.0. The configs set
`fourcc: MJPG` for this reason; without it you get
`failed to set fps=30 (actual_fps=10.0)`.

### The ODrive base (USB)

The two brushless wheels hang off an ODESC/ODrive board on USB. It is not a
serial port: the `odrive` python package drives it through libusb, and
libusb needs the raw USB node to be writable, which it is not by default.
The symptom of a missing rule is `odrive.find_any()` timing out as if no
board were plugged in.

```bash
lsusb | grep -i 1209          # expect 1209:0d32  (0d31 = DFU mode, wrong)
sudo cp config/99-odrive-elroy.rules /etc/udev/rules.d/99-odrive.rules
sudo udevadm control --reload-rules
sudo udevadm trigger --action=add --subsystem-match=usb
```

Then, once, from the robot's own environment, confirm it answers and read
the bus voltage — this is also the first thing to run if the base ever
stops responding:

```bash
uv run --project ~/GitHub/XLeRobot python -c "import odrive; o=odrive.find_any(timeout=10); print(o.serial_number, o.vbus_voltage, 'V')"
```

The robot type is `xlerobot_2wheels_odrive` (a subclass of `xlerobot`; same
calibration file, since the wheels are not in it). Bus 2 carries the right
arm only. The operator's `emit_y_vel` must be `false` — a differential
drive has no sideways axis. `odrive_base.py` assumes 0.5.x firmware with
`axis0` (M0) = right and `axis1` (M1) = left; if forward drives a circle, flip
`invert_left_wheel` / `invert_right_wheel` in the yaml.

### RealSense permissions

The RealSense is addressed by serial number, so it needs no naming rule —
but libusb access may need librealsense's own permissions rules. Test first:

```bash
uv run lerobot-find-cameras realsense
```

If it reports no device while `lsusb` clearly shows it, that is a
permissions problem, not a wiring one. Install librealsense's
`99-realsense-libusb.rules` and make sure your user is in the `video` and
`plugdev` groups (`id -nG`), then re-plug the camera.

Headless check of all three at once:

```bash
uv run lerobot-find-cameras
```

---

## 5. Calibrate

Calibration lives on the machine the motors are attached to, so this is a
fresh calibration on the Orin even though the arms were calibrated on the
Pi. The per-arm files there are `so_follower/xlerobot_arms_{left,right}.json`
with motor names like `shoulder_pan`; `xlerobot` wants one file,
`robots/xlerobot/<id>.json`, with names like `left_arm_shoulder_pan`. Not
interchangeable — recalibrate rather than convert.

```bash
cd ~/GitHub/XLeRobot
uv run lerobot-calibrate \
  --robot.type=xlerobot \
  --robot.id=xlerobot \
  --robot.port1=/dev/serial/by-id/usb-1a86_USB_Single_Serial_5A7A058116-if00 \
  --robot.port2=/dev/serial/by-id/usb-1a86_USB_Single_Serial_5B91028673-if00
```

It runs in two passes, and the prompts matter:

1. **bus1 — left arm and head.** Move them to the middle of their range,
   press ENTER, then move every joint through its full travel.
2. **bus2 — right arm.** Same. The three base wheels are handled
   automatically: homing offset 0 and a full-turn range, since a wheel has
   no end stops to find.

Homing offsets are per-unit physical facts. Swapping which arm sits behind
an id means recalibrating, not renaming.

Check:

```bash
C=$(uv run python -c \
  "from lerobot.utils.constants import HF_LEROBOT_CALIBRATION as C; print(C)")
find "$C" -name '*.json' | sed "s|$C/||" | sort
```

You want `robots/xlerobot/xlerobot.json`.

---

## 6. Self-test

The payoff. One machine, everything local.

```bash
./config/cart-selftest.sh
```

Read-only: connects both buses and all three cameras, reports the
observation rate, prints all 17 state values, and writes one frame per
camera to `./selftest-frames/`.

What to look for:

- **Observation rate ≥ 30 Hz.** Below that, recording cannot keep its
  contract. It is almost always a camera rather than the servos — confirm
  with `--no-cameras`, which should jump to several hundred Hz.
- **Joint values that vary between reads.** A dead servo often reads an
  exact constant while its neighbours jitter.
- **The PNGs.** Open them. A camera can be live, correctly sized and
  pointed at the wrong thing, and no automated check catches that.

Then the movement tests, each asking before it moves anything:

```bash
./config/cart-selftest.sh --head          # sweeps both head servos +/-12 deg
./config/cart-selftest.sh --arms          # nudges all 12 arm joints 5 deg
./config/cart-selftest.sh --base          # drives the wheels — ON BLOCKS
```

`--base` is the one that answers "can you see the base". It commands
forward, backward and both turns, then reads `x.vel` / `theta.vel` back out
of the observation. Those come from the wheels' `Present_Velocity` through
`_wheel_raw_to_body`, so a plausible number means the whole chain works:
command → kinematics → bus → servo → encoder → kinematics → observation.

Watch the wheels as well as the numbers. Body velocity is derived from all
three, so two correct wheels can mask a third spinning backwards.

---

## 7. Then, and only then

- `BASE=none ./config/cart-selftest.sh --head --arms` — arms and head on
  their own, before the base or the network is in the picture.
- `config/operator-leader-host.sh` on the Pi and `config/cart-teleop.sh`
  here — the split.
- `config/cart-record.sh` — recording.

Each of those adds exactly one new thing. When something breaks, it is the
thing you just added.

### Video decoding: PyAV, not torchcodec (2026-10-15)

`torchcodec` installs (0.12, matching torch 2.12) but its native library
cannot load here: it uses the **system** FFmpeg, and NVIDIA's FFmpeg 8
(`ffmpeg 7:8.0.1-nvidia1`, from repo.download.nvidia.com/jetson/ffmpeg)
ships no `libswscale`. torchcodec's FFmpeg-8 module needs
`libswscale.so.9`; there is no package for it. Ubuntu's FFmpeg 6 is half
present too (missing `libavdevice60`, `libavfilter9`), and completing it
would make torchcodec load - **deliberately not done**, to leave the system
FFmpeg exactly as NVIDIA installs it.

Nothing needs it. Recording encodes with PyAV, which carries its own
FFmpeg inside the venv; inference uses live frames. Reading a dataset back
falls back to PyAV automatically (lerobot `import_utils.py`, FORK-LOCAL:
it probes `torchcodec.decoders`, the import that actually loads the
library). `./config/sync.sh` reports the state. Train on a machine where
torchcodec loads if decode speed ever matters.

### Wifi power saving off - here and on rosie (2026-10-27)

NetworkManager turns wifi power saving on by default, on the Orin and on
the Pi alike. The radio then dozes between bursts, and a link that reports
540 Mbit/s on 5 GHz delivers a fraction of that with whole seconds of
nothing: `iperf3 -c <mac>` from elroy measured 10 Mbit/s with two dead
seconds out of ten. Video piles up behind those gaps - the viewer ran 9-11 s
behind on every camera - and the leader actions queue with it
(`Leader link stalled ... 300ms` about once a second). Turning it off
removed the dead seconds.

Here (the interface is `wlP1p1s0`, the connection `homenet`):

```bash
sudo iw dev wlP1p1s0 set power_save off                              # now
sudo nmcli connection modify homenet 802-11-wireless.powersave 2     # every reconnect and boot
nmcli -g 802-11-wireless.powersave connection show homenet           # -> disable
```

On rosie it is the same with `wlan0` and the connection Raspberry Pi Imager
created, `preconfigured`. `iw` is in `/usr/sbin` there, so a plain
`ssh rosie iw ...` reports it missing; use `sudo` or the full path.

```bash
sudo iw dev wlan0 set power_save off
sudo nmcli connection modify preconfigured 802-11-wireless.powersave 2
```

Find the names with `iw dev` and
`nmcli -t -f NAME,DEVICE connection show --active` if they change.

That is not the whole of it on elroy. With `iw` showing power save off it
still measured 3-20 Mbit/s each way, at -57 dBm and a 175 Mbit/s tx rate,
while rosie through the same access point did 175. The card is the
RTL8822CE, and JetPack loads NVIDIA's out-of-tree `rtl8822ce` driver, which
has its own power management underneath `iw`: `rtw_power_mgnt=2` (maximum)
and `rtw_ips_mode=1`. Both are load-time options, so this is a file and a
reboot:

```bash
echo "options rtl8822ce rtw_power_mgnt=0 rtw_ips_mode=0" | sudo tee /etc/modprobe.d/rtl8822ce-nopowersave.conf
sudo reboot
cat /sys/module/rtl8822ce/parameters/rtw_power_mgnt   # -> 0
cat /sys/module/rtl8822ce/parameters/rtw_ips_mode     # -> 0
```

After it: 108 Mbit/s elroy -> Mac, six retransmissions in ten seconds, and
the viewer keeps up. NVIDIA's own `nvidia-preferred-oot-modules.conf` in
`/etc/modprobe.d/` only picks this driver over the in-tree `rtw88`; it sets
no options, so the two files do not conflict.

elroy still transmits on one spatial stream (`iw dev wlP1p1s0 link` shows
`tx ... VHT-NSS 1` against `rx ... VHT-NSS 2`). Reseating the two antenna
leads on the M.2 card is the next thing to try if the link is ever short.
