carlkesselman/XLeRobot/software/src/robots/xlerobot_2wheels_odrive/odesc-wiring-diagram.png

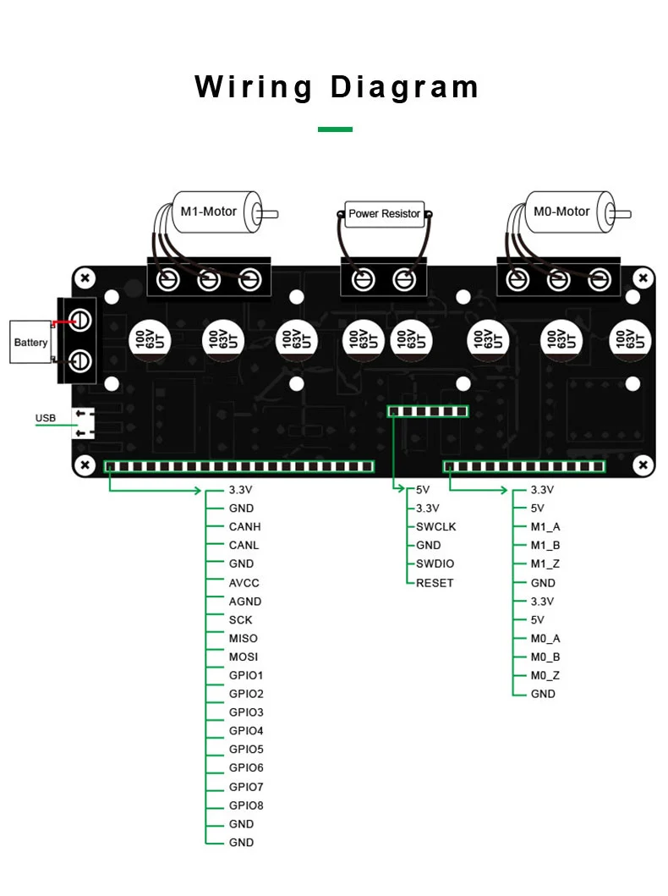
software/src/robots/xlerobot_2wheels_odrive/odesc-wiring-diagram.png
