carlkesselman/XLeRobot/software/src/robots/xlerobot/xlerobot.py

#!/usr/bin/env python

# Copyright 2024 The HuggingFace Inc. team. All rights reserved.
#
# Licensed under the Apache License, Version 2.0 (the "License");
# you may not use this file except in compliance with the License.
# You may obtain a copy of the License at
#
#     http://www.apache.org/licenses/LICENSE-2.0
#
# Unless required by applicable law or agreed to in writing, software
# distributed under the License is distributed on an "AS IS" BASIS,
# WITHOUT WARRANTIES OR CONDITIONS OF ANY KIND, either express or implied.
# See the License for the specific language governing permissions and
# limitations under the License.

import logging
import sys
import time
from functools import cached_property
from itertools import chain
from typing import Any

import numpy as np

from lerobot.cameras.utils import make_cameras_from_configs
from lerobot.utils.errors import DeviceAlreadyConnectedError, DeviceNotConnectedError
from lerobot.motors import Motor, MotorCalibration, MotorNormMode
from lerobot.motors.feetech import (
    FeetechMotorsBus,
    OperatingMode,
)

from lerobot.robots.robot import Robot
from lerobot.robots.utils import ensure_safe_goal_position
from .config_xlerobot import XLerobotConfig

logger = logging.getLogger(__name__)

# Seventeen servos daisy-chained at 1 Mbaud drop a packet occasionally. A
# dropped reply is not a fault - it is the medium - but lerobot's
# enable_torque/disable_torque default to num_retry=0, so one lost status
# packet during configure() aborts the whole connect with
#
#   Failed to write 'Torque_Enable' on id_=6 ... There is no status packet!
#
# Measured before adding this: every motor answers, the supply holds 12.0 V
# with zero sag under progressive load, and the same write succeeds with
# retries on the same motor seconds later. stop_base() upstream already
# uses num_retry=5 for the same reason.
BUS_RETRY = 3
# How many consecutive failed state reads to ride out on the last good
# state before giving up. 10 ticks at 30 Hz is a third of a second - long
# enough to absorb a burst of bad packets, short enough that a bus that has
# actually gone away is not driven blind for long.
MAX_CONSECUTIVE_READ_FAILURES = 10


class XLerobot(Robot):
    """
    The robot includes a three omniwheel mobile base and a remote follower arm.
    The leader arm is connected locally (on the laptop) and its joint positions are recorded and then
    forwarded to the remote follower arm (after applying a safety clamp).
    In parallel, keyboard teleoperation is used to generate raw velocity commands for the wheels.
    """

    config_class = XLerobotConfig
    name = "xlerobot"

    def __init__(self, config: XLerobotConfig):
        super().__init__(config)
        self.config = config
        self.teleop_keys = config.teleop_keys
        # Define three speed levels and a current index
        self.speed_levels = [
            {"xy": 0.1, "theta": 30},  # slow
            {"xy": 0.2, "theta": 60},  # medium
            {"xy": 0.3, "theta": 90},  # fast
        ]
        self.speed_index = 0  # Start at slow
        norm_mode_body = MotorNormMode.DEGREES if config.use_degrees else MotorNormMode.RANGE_M100_100
        if self.calibration.get("left_arm_shoulder_pan") is not None:
            calibration1 = {
                "left_arm_shoulder_pan": self.calibration.get("left_arm_shoulder_pan"),
                "left_arm_shoulder_lift": self.calibration.get("left_arm_shoulder_lift"),
                "left_arm_elbow_flex": self.calibration.get("left_arm_elbow_flex"), 
                "left_arm_wrist_flex": self.calibration.get("left_arm_wrist_flex"),
                "left_arm_wrist_roll": self.calibration.get("left_arm_wrist_roll"),
                "left_arm_gripper": self.calibration.get("left_arm_gripper"),
                "head_motor_1": self.calibration.get("head_motor_1"),
                "head_motor_2": self.calibration.get("head_motor_2"),
            }
        else:
            calibration1 = self.calibration
        
        self.bus1 = FeetechMotorsBus(
            port=self.config.port1,
            motors={
                # left arm
                "left_arm_shoulder_pan": Motor(1, "sts3215", norm_mode_body),
                "left_arm_shoulder_lift": Motor(2, "sts3215", norm_mode_body),
                "left_arm_elbow_flex": Motor(3, "sts3215", norm_mode_body),
                "left_arm_wrist_flex": Motor(4, "sts3215", norm_mode_body),
                "left_arm_wrist_roll": Motor(5, "sts3215", norm_mode_body),
                "left_arm_gripper": Motor(6, "sts3215", MotorNormMode.RANGE_0_100),
                # head
                "head_motor_1": Motor(7, "sts3215", norm_mode_body),
                "head_motor_2": Motor(8, "sts3215", norm_mode_body),
            },
            calibration= calibration1,
        )
        if self.calibration.get("right_arm_shoulder_pan") is not None:
            bus2_names = list(self._bus2_motors(norm_mode_body))
            calibration2 = {name: self.calibration.get(name) for name in bus2_names}
        else:
            calibration2 = self.calibration
        self.bus2= FeetechMotorsBus(
            port=self.config.port2,
            motors=self._bus2_motors(norm_mode_body),
            calibration=calibration2,
        )
        self.left_arm_motors = [motor for motor in self.bus1.motors if motor.startswith("left_arm")]
        self.right_arm_motors = [motor for motor in self.bus2.motors if motor.startswith("right_arm")]
        self.head_motors = [motor for motor in self.bus1.motors if motor.startswith("head")]
        self.base_motors = [motor for motor in self.bus2.motors if motor.startswith("base")]

        # Last good state read, and how many reads in a row have failed.
        # See get_observation().
        self._last_proprio: tuple[dict, dict, dict] | None = None
        self._read_failures = 0
        self.cameras = make_cameras_from_configs(config.cameras)

    # ------------------------------------------------------------------ base
    #
    # Everything the base contributes goes through these hooks, so a robot
    # with a different base - two brushless wheels on an ODrive, say -
    # subclasses this and overrides only them. The arms, head, cameras,
    # calibration, bus retries, disconnect ordering and servo profiles are
    # inherited, and a fix made here is a fix made there. (The ODrive robot
    # used to be a copy of this file; it had none of the hardening added
    # since, and that is how two robots drift apart.)
    #
    # Defaults below are the three STS3215 omniwheels on bus 2, or no base at
    # all when config.base == "none": then bus 2 carries the right arm only,
    # the base contributes no features, and base commands are dropped with
    # a single warning.

    @property
    def _has_servo_base(self) -> bool:
        return self.config.base == "omniwheels"

    def _bus2_motors(self, norm_mode_body: MotorNormMode) -> dict[str, Motor]:
        """Motor table for bus 2. The right arm, plus whatever base lives there."""
        motors = {
            # right arm
            "right_arm_shoulder_pan": Motor(1, "sts3215", norm_mode_body),
            "right_arm_shoulder_lift": Motor(2, "sts3215", norm_mode_body),
            "right_arm_elbow_flex": Motor(3, "sts3215", norm_mode_body),
            "right_arm_wrist_flex": Motor(4, "sts3215", norm_mode_body),
            "right_arm_wrist_roll": Motor(5, "sts3215", norm_mode_body),
            "right_arm_gripper": Motor(6, "sts3215", MotorNormMode.RANGE_0_100),
        }
        if self._has_servo_base:
            motors.update({
                "base_left_wheel": Motor(7, "sts3215", MotorNormMode.RANGE_M100_100),
                "base_back_wheel": Motor(8, "sts3215", MotorNormMode.RANGE_M100_100),
                "base_right_wheel": Motor(9, "sts3215", MotorNormMode.RANGE_M100_100),
            })
        return motors

    @property
    def _base_state_keys(self) -> tuple[str, ...]:
        """The base's entries in the observation and action spaces."""
        return ("x.vel", "y.vel", "theta.vel") if self._has_servo_base else ()

    @property
    def _base_is_connected(self) -> bool:
        return True  # the omniwheels ride on bus 2; no base is always "connected"

    def _connect_base(self) -> None:
        pass  # bus 2 is connected with the arms

    def _disconnect_base(self) -> None:
        pass

    def _read_base_velocity(self) -> dict[str, float]:
        """Measured body velocity. Raise ConnectionError if the base did not answer."""
        if not self._has_servo_base:
            return {}
        wheel_vel = self.bus2.sync_read("Present_Velocity", self.base_motors, num_retry=BUS_RETRY)
        return self._wheel_raw_to_body(
            wheel_vel["base_left_wheel"],
            wheel_vel["base_back_wheel"],
            wheel_vel["base_right_wheel"],
        )

    def _send_base_velocity(self, x_mps: float, y_mps: float, theta_degps: float) -> None:
        if not self._has_servo_base:
            self._warn_no_base(x_mps, y_mps, theta_degps)
            return
        wheel_goal = self._body_to_wheel_raw(x_mps, y_mps, theta_degps)
        if wheel_goal:
            self.bus2.sync_write("Goal_Velocity", wheel_goal)

    def stop_base(self):
        if not self.base_motors:
            return
        self.bus2.sync_write("Goal_Velocity", dict.fromkeys(self.base_motors, 0), num_retry=5)
        logger.info("Base motors stopped")

    def _warn_no_base(self, *vel: float) -> None:
        """base: none, but the operator is sending base commands. Say so once."""
        if any(abs(v) > 1e-6 for v in vel) and not getattr(self, "_warned_no_base", False):
            self._warned_no_base = True
            logger.warning(
                "%s has no base (base: none) but received a nonzero base command; "
                "ignoring these. The operator config is still emitting them.", self
            )

    @property
    def _state_ft(self) -> dict[str, type]:
        return dict.fromkeys(
            (
                "left_arm_shoulder_pan.pos",
                "left_arm_shoulder_lift.pos",
                "left_arm_elbow_flex.pos",
                "left_arm_wrist_flex.pos",
                "left_arm_wrist_roll.pos",
                "left_arm_gripper.pos",
                "right_arm_shoulder_pan.pos",
                "right_arm_shoulder_lift.pos",
                "right_arm_elbow_flex.pos",
                "right_arm_wrist_flex.pos",
                "right_arm_wrist_roll.pos",
                "right_arm_gripper.pos",
                "head_motor_1.pos",
                "head_motor_2.pos",
                *self._base_state_keys,
            ),
            float,
        )

    @property
    def _cameras_ft(self) -> dict[str, tuple]:
        return {
            cam: (self.config.cameras[cam].height, self.config.cameras[cam].width, 3) for cam in self.cameras
        }

    @cached_property
    def observation_features(self) -> dict[str, type | tuple]:
        return {**self._state_ft, **self._cameras_ft}

    @cached_property
    def action_features(self) -> dict[str, type]:
        return self._state_ft

    @property
    def is_connected(self) -> bool:
        return (
            self.bus1.is_connected
            and self.bus2.is_connected
            and self._base_is_connected
            and all(cam.is_connected for cam in self.cameras.values())
        )

    def connect(self, calibrate: bool = True) -> None:
        if self.is_connected:
            raise DeviceAlreadyConnectedError(f"{self} already connected")

        self.bus1.connect()
        self.bus2.connect()
        
        # Check if calibration file exists and ask user if they want to restore it
        if self.calibration_fpath.is_file():
            logger.info(f"Calibration file found at {self.calibration_fpath}")

            # Only ask a human who is actually there. This used to prompt
            # unconditionally, which hangs every non-interactive run - a
            # scheduled recording, a systemd unit, anything with a pipe for
            # stdin - on an input() nobody can answer, with no output to say
            # why. calibrate=False means "do not calibrate", so there is
            # nothing to offer either.
            user_input = ""
            if calibrate and sys.stdin is not None and sys.stdin.isatty():
                user_input = input(
                    "Press ENTER to restore calibration from file, or type 'c' and press ENTER to run manual calibration: "
                )
            if user_input.strip().lower() != "c":
                logger.info("Attempting to restore calibration from file...")
                try:
                    # Load calibration data into bus memory
                    self.bus1.calibration = {k: v for k, v in self.calibration.items() if k in self.bus1.motors}
                    self.bus2.calibration = {k: v for k, v in self.calibration.items() if k in self.bus2.motors}
                    logger.info("Calibration data loaded into bus memory successfully!")
                    
                    # Write calibration data to motors. write_calibration()
                    # issues one bare write per motor per register with no
                    # retry of its own, so retry the whole call.
                    self._retry(
                        lambda: self.bus1.write_calibration(
                            {k: v for k, v in self.calibration.items() if k in self.bus1.motors}
                        ),
                        "bus1 write_calibration",
                    )
                    self._retry(
                        lambda: self.bus2.write_calibration(
                            {k: v for k, v in self.calibration.items() if k in self.bus2.motors}
                        ),
                        "bus2 write_calibration",
                    )
                    logger.info("Calibration restored successfully from file!")
                    
                except Exception as e:
                    # Do NOT fall through to calibrate() here. A dropped
                    # packet during write_calibration is transient; manual
                    # calibration is destructive - one reflexive ENTER at
                    # the prompt rewrites Homing_Offset in every motor.
                    # Twice this nearly cost the calibration. If the file
                    # cannot be written to the motors, say so and stop;
                    # the operator can pass 'c' at the prompt on purpose.
                    raise RuntimeError(
                        f"Failed to restore calibration from {self.calibration_fpath}: {e}. "
                        "Not falling through to manual calibration. Check the buses and retry; "
                        "if the file is genuinely bad, answer 'c' at the prompt to recalibrate."
                    ) from e
            else:
                logger.info("User chose manual calibration...")
                if calibrate:
                    self.calibrate()
        elif calibrate:
            logger.info("No calibration file found, proceeding with manual calibration...")
            self.calibrate()

        for cam in self.cameras.values():
            cam.connect()

        self.configure()
        self._connect_base()
        logger.info(f"{self} connected.")

    @property
    def is_calibrated(self) -> bool:
        return self.bus1.is_calibrated and self.bus2.is_calibrated

    def calibrate(self) -> None:
        logger.info(f"\nRunning calibration of {self}")
        ## calib left motors
        left_motors = self.left_arm_motors + self.head_motors
        self.bus1.disable_torque()
        for name in left_motors:
            self.bus1.write("Operating_Mode", name, OperatingMode.POSITION.value)
        input(
            "Move left arm and head motors to the middle of their range of motion and press ENTER...."
        )
        homing_offsets = self.bus1.set_half_turn_homings(left_motors)
        homing_offsets.update(dict.fromkeys(self.right_arm_motors + self.base_motors, 0))
        
        print(
            f"Move all left arm and head joints sequentially through their "
            "entire ranges of motion.\nRecording positions. Press ENTER to stop..."
        )
        range_mins, range_maxes = self.bus1.record_ranges_of_motion(left_motors)
        
        calibration_left = {}
        for name, motor in self.bus1.motors.items():
            calibration_left[name] = MotorCalibration(
                id=motor.id,
                drive_mode=0,
                homing_offset=homing_offsets[name],
                range_min=range_mins[name],
                range_max=range_maxes[name],
            )
        
        self.bus1.write_calibration(calibration_left)
        
        # calib right motors
        right_motors = self.right_arm_motors + self.base_motors
        self.bus2.disable_torque(self.right_arm_motors)
        for name in self.right_arm_motors:
            self.bus2.write("Operating_Mode", name, OperatingMode.POSITION.value)
        
        input(
            "Move right arm motors to the middle of their range of motion and press ENTER...."
        )
        
        homing_offsets = self.bus2.set_half_turn_homings(self.right_arm_motors)
        homing_offsets.update(dict.fromkeys(self.base_motors, 0))
        
        full_turn_motor = [
            motor for motor in right_motors if any(keyword in motor for keyword in ["wheel"])
        ]
        
        unknown_range_motors = [motor for motor in right_motors if motor not in full_turn_motor]
        print(
            f"Move all right arm joints except '{full_turn_motor}' sequentially through their "
            "entire ranges of motion.\nRecording positions. Press ENTER to stop..."
        )
        range_mins, range_maxes = self.bus2.record_ranges_of_motion(unknown_range_motors)
        for name in full_turn_motor:
            range_mins[name] = 0
            range_maxes[name] = 4095
        
        calibration_right = {}
        
        for name, motor in self.bus2.motors.items():
            calibration_right[name] = MotorCalibration(
                id=motor.id,
                drive_mode=0,
                homing_offset=homing_offsets[name],
                range_min=range_mins[name],
                range_max=range_maxes[name],
            )
        
        self.bus2.write_calibration(calibration_right)
        self.calibration = {**calibration_left, **calibration_right}
        self._save_calibration()
        print("Calibration saved to", self.calibration_fpath)
        

    @staticmethod
    def _retry(fn, what: str, tries: int = BUS_RETRY + 1):
        """Call fn() up to `tries` times. For bus methods that take no num_retry."""
        last: Exception | None = None
        for attempt in range(1, tries + 1):
            try:
                return fn()
            except Exception as e:  # noqa: BLE001
                last = e
                if attempt < tries:
                    logger.warning(f"{what} failed (attempt {attempt}/{tries}): {e}; retrying")
                    time.sleep(0.05)
        raise RuntimeError(f"{what} failed after {tries} attempts: {last}") from last

    def configure(self):
        # Set-up arm actuators (position mode)
        # We assume that at connection time, arm is in a rest position,
        # and torque can be safely disabled to run calibration
        
        # configure_motors() writes three registers per motor with no retry
        # of its own; wrap the call so one dropped packet does not abort
        # connect().
        self.bus1.disable_torque(num_retry=BUS_RETRY)
        self._retry(self.bus1.configure_motors, "bus1 configure_motors")

        self.bus2.disable_torque(num_retry=BUS_RETRY)
        self._retry(self.bus2.configure_motors, "bus2 configure_motors")
        
        
        for name in self.left_arm_motors:
            self.bus1.write("Operating_Mode", name, OperatingMode.POSITION.value, num_retry=BUS_RETRY)
            # Set P_Coefficient to lower value to avoid shakiness (Default is 32)
            self.bus1.write("P_Coefficient", name, 16, num_retry=BUS_RETRY)
            # Set I_Coefficient and D_Coefficient to default value 0 and 32
            self.bus1.write("I_Coefficient", name, 0, num_retry=BUS_RETRY)
            self.bus1.write("D_Coefficient", name, 43, num_retry=BUS_RETRY)
            # Cap the ramp, which caps the inrush. See the config for why.
            self.bus1.write(
                "Acceleration", name, self.config.arm_acceleration, normalize=False, num_retry=BUS_RETRY
            )
        
        for name in self.head_motors:
            self.bus1.write("Operating_Mode", name, OperatingMode.POSITION.value, num_retry=BUS_RETRY)
            # Set P_Coefficient to lower value to avoid shakiness (Default is 32)
            self.bus1.write("P_Coefficient", name, 16, num_retry=BUS_RETRY)
            # Set I_Coefficient and D_Coefficient to default value 0 and 32
            self.bus1.write("I_Coefficient", name, 0, num_retry=BUS_RETRY)
            self.bus1.write("D_Coefficient", name, 43, num_retry=BUS_RETRY)
            # A motion profile, so a 30 Hz stream of small position steps is
            # executed as a glide rather than thirty jumps a second. The arms
            # keep configure_motors()' Acceleration=254; see the config for why
            # the head is different. Raw, not normalised: these are not
            # positions.
            self.bus1.write(
                "Goal_Velocity", name, self.config.head_goal_velocity, normalize=False, num_retry=BUS_RETRY
            )
            self.bus1.write(
                "Acceleration", name, self.config.head_acceleration, normalize=False, num_retry=BUS_RETRY
            )
        
        for name in self.right_arm_motors:
            self.bus2.write("Operating_Mode", name, OperatingMode.POSITION.value, num_retry=BUS_RETRY)
            # Set P_Coefficient to lower value to avoid shakiness (Default is 32)
            self.bus2.write("P_Coefficient", name, 16, num_retry=BUS_RETRY)
            # Set I_Coefficient and D_Coefficient to default value 0 and 32
            self.bus2.write("I_Coefficient", name, 0, num_retry=BUS_RETRY)
            self.bus2.write("D_Coefficient", name, 43, num_retry=BUS_RETRY)
            # Cap the ramp, which caps the inrush. See the config for why.
            self.bus2.write(
                "Acceleration", name, self.config.arm_acceleration, normalize=False, num_retry=BUS_RETRY
            )
        
        for name in self.base_motors:
            self.bus2.write("Operating_Mode", name, OperatingMode.VELOCITY.value, num_retry=BUS_RETRY)
        
        
        self.bus1.enable_torque(num_retry=BUS_RETRY)
        self.bus2.enable_torque(num_retry=BUS_RETRY)
        

    def setup_motors(self) -> None:
        for motor in chain(reversed(self.left_arm_motors), reversed(self.head_motors)):
            input(f"Connect the controller board to the '{motor}' motor only and press enter.")
            self.bus1.setup_motor(motor)
            print(f"'{motor}' motor id set to {self.bus1.motors[motor].id}")
        
        # Set up right arm motors
        for motor in chain(reversed(self.right_arm_motors), reversed(self.base_motors)):
            input(f"Connect the controller board to the '{motor}' motor only and press enter.")
            self.bus2.setup_motor(motor)
            print(f"'{motor}' motor id set to {self.bus2.motors[motor].id}")
        

    @staticmethod
    def _degps_to_raw(degps: float) -> int:
        steps_per_deg = 4096.0 / 360.0
        speed_in_steps = degps * steps_per_deg
        speed_int = int(round(speed_in_steps))
        # Cap the value to fit within signed 16-bit range (-32768 to 32767)
        if speed_int > 0x7FFF:
            speed_int = 0x7FFF  # 32767 -> maximum positive value
        elif speed_int < -0x8000:
            speed_int = -0x8000  # -32768 -> minimum negative value
        return speed_int

    @staticmethod
    def _raw_to_degps(raw_speed: int) -> float:
        steps_per_deg = 4096.0 / 360.0
        magnitude = raw_speed
        degps = magnitude / steps_per_deg
        return degps

    def _body_to_wheel_raw(
        self,
        x: float,
        y: float,
        theta: float,
        wheel_radius: float = 0.05,
        base_radius: float = 0.125,
        max_raw: int = 3000,
    ) -> dict:
        """
        Convert desired body-frame velocities into wheel raw commands.

        Parameters:
          x_cmd      : Linear velocity in x (m/s).
          y_cmd      : Linear velocity in y (m/s).
          theta_cmd  : Rotational velocity (deg/s).
          wheel_radius: Radius of each wheel (meters).
          base_radius : Distance from the center of rotation to each wheel (meters).
          max_raw    : Maximum allowed raw command (ticks) per wheel.

        Returns:
          A dictionary with wheel raw commands:
             {"base_left_wheel": value, "base_back_wheel": value, "base_right_wheel": value}.

        Notes:
          - Internally, the method converts theta_cmd to rad/s for the kinematics.
          - The raw command is computed from the wheels angular speed in deg/s
            using _degps_to_raw(). If any command exceeds max_raw, all commands
            are scaled down proportionally.
        """
        # Convert rotational velocity from deg/s to rad/s.
        theta_rad = theta * (np.pi / 180.0)
        # Create the body velocity vector [x, y, theta_rad].
        velocity_vector = np.array([x, y, theta_rad])

        # Define the wheel mounting angles with a -90° offset.
        angles = np.radians(np.array([240, 0, 120]) - 90)
        # Build the kinematic matrix: each row maps body velocities to a wheel’s linear speed.
        # The third column (base_radius) accounts for the effect of rotation.
        m = np.array([[np.cos(a), np.sin(a), base_radius] for a in angles])

        # Compute each wheel’s linear speed (m/s) and then its angular speed (rad/s).
        wheel_linear_speeds = m.dot(velocity_vector)
        wheel_angular_speeds = wheel_linear_speeds / wheel_radius

        # Convert wheel angular speeds from rad/s to deg/s.
        wheel_degps = wheel_angular_speeds * (180.0 / np.pi)

        # Scaling
        steps_per_deg = 4096.0 / 360.0
        raw_floats = [abs(degps) * steps_per_deg for degps in wheel_degps]
        max_raw_computed = max(raw_floats)
        if max_raw_computed > max_raw:
            scale = max_raw / max_raw_computed
            wheel_degps = wheel_degps * scale

        # Convert each wheel’s angular speed (deg/s) to a raw integer.
        wheel_raw = [self._degps_to_raw(deg) for deg in wheel_degps]

        return {
            "base_left_wheel": wheel_raw[0],
            "base_back_wheel": wheel_raw[1],
            "base_right_wheel": wheel_raw[2],
        }

    def _wheel_raw_to_body(
        self,
        left_wheel_speed,
        back_wheel_speed,
        right_wheel_speed,
        wheel_radius: float = 0.05,
        base_radius: float = 0.125,
    ) -> dict[str, Any]:
        """
        Convert wheel raw command feedback back into body-frame velocities.

        Parameters:
          wheel_raw   : Vector with raw wheel commands ("base_left_wheel", "base_back_wheel", "base_right_wheel").
          wheel_radius: Radius of each wheel (meters).
          base_radius : Distance from the robot center to each wheel (meters).

        Returns:
          A dict (x.vel, y.vel, theta.vel) all in m/s
        """

        # Convert each raw command back to an angular speed in deg/s.
        wheel_degps = np.array(
            [
                self._raw_to_degps(left_wheel_speed),
                self._raw_to_degps(back_wheel_speed),
                self._raw_to_degps(right_wheel_speed),
            ]
        )

        # Convert from deg/s to rad/s.
        wheel_radps = wheel_degps * (np.pi / 180.0)
        # Compute each wheel’s linear speed (m/s) from its angular speed.
        wheel_linear_speeds = wheel_radps * wheel_radius

        # Define the wheel mounting angles with a -90° offset.
        angles = np.radians(np.array([240, 0, 120]) - 90)
        m = np.array([[np.cos(a), np.sin(a), base_radius] for a in angles])

        # Solve the inverse kinematics: body_velocity = M⁻¹ · wheel_linear_speeds.
        m_inv = np.linalg.inv(m)
        velocity_vector = m_inv.dot(wheel_linear_speeds)
        x, y, theta_rad = velocity_vector
        theta = theta_rad * (180.0 / np.pi)
        return {
            "x.vel": x,
            "y.vel": y,
            "theta.vel": theta,
        }  # m/s and deg/s
    
    def _from_keyboard_to_base_action(self, pressed_keys: np.ndarray):
        if not self._base_state_keys:
            return {}
        # Speed control
        if self.teleop_keys["speed_up"] in pressed_keys:
            self.speed_index = min(self.speed_index + 1, 2)
        if self.teleop_keys["speed_down"] in pressed_keys:
            self.speed_index = max(self.speed_index - 1, 0)
        speed_setting = self.speed_levels[self.speed_index]
        xy_speed = speed_setting["xy"]  # e.g. 0.1, 0.25, or 0.4
        theta_speed = speed_setting["theta"]  # e.g. 30, 60, or 90

        x_cmd = 0.0  # m/s forward/backward
        y_cmd = 0.0  # m/s lateral
        theta_cmd = 0.0  # deg/s rotation

        if self.teleop_keys["forward"] in pressed_keys:
            x_cmd += xy_speed
        if self.teleop_keys["backward"] in pressed_keys:
            x_cmd -= xy_speed
        if self.teleop_keys["left"] in pressed_keys:
            y_cmd += xy_speed
        if self.teleop_keys["right"] in pressed_keys:
            y_cmd -= xy_speed
        if self.teleop_keys["rotate_left"] in pressed_keys:
            theta_cmd += theta_speed
        if self.teleop_keys["rotate_right"] in pressed_keys:
            theta_cmd -= theta_speed
            
        return {
            # "head_motor_1.pos": 0.0,  # Head motors are not controlled by keyboard
            # "head_motor_2.pos": 0.0,  # TODO: implement head control
            "x.vel": x_cmd, 
            "y.vel": y_cmd,
            "theta.vel": theta_cmd,
        }

    def get_observation(self) -> dict[str, Any]:
        if not self.is_connected:
            raise DeviceNotConnectedError(f"{self} is not connected.")

        # Read actuators position for arm and vel for base.
        #
        # Three transactions, not four: bus 1 reads the left arm and the head
        # in one Present_Position sync_read. Fewer packets is fewer chances
        # for one to come back corrupted, and a shorter window between the
        # proprioception and the images read next.
        #
        # Every read retries. A bus with 17 servos drops a reply now and
        # then - "[TxRxResult] Incorrect status packet!" - and at 90
        # transactions a second a 30-minute session is a statistical
        # certainty. With num_retry=0 that one packet ended the run, lost the
        # episode, and (because disconnect() was skipped on the way out)
        # could leave the base driving. Now it is retried, and if the bus is
        # genuinely gone for a moment the last good state is reused for a
        # few ticks before giving up, so a recording survives a burst.
        start = time.perf_counter()
        try:
            bus1_pos = self.bus1.sync_read(
                "Present_Position", self.left_arm_motors + self.head_motors, num_retry=BUS_RETRY
            )
            right_arm_pos = self.bus2.sync_read(
                "Present_Position", self.right_arm_motors, num_retry=BUS_RETRY
            )
            base_vel = self._read_base_velocity()
        except ConnectionError as e:
            self._read_failures += 1
            if self._last_proprio is None or self._read_failures > MAX_CONSECUTIVE_READ_FAILURES:
                raise
            if self._read_failures == 1 or self._read_failures % 10 == 0:
                logger.warning(
                    "%s: state read failed (%d in a row), reusing last good state: %s",
                    self, self._read_failures, e,
                )
            bus1_pos, right_arm_pos, base_vel = self._last_proprio
        else:
            if self._read_failures:
                logger.info("%s: state reads recovered after %d failure(s)", self, self._read_failures)
            self._read_failures = 0
            self._last_proprio = (bus1_pos, right_arm_pos, base_vel)

        left_arm_pos = {k: bus1_pos[k] for k in self.left_arm_motors}
        head_pos = {k: bus1_pos[k] for k in self.head_motors}
        
        left_arm_state = {f"{k}.pos": v for k, v in left_arm_pos.items()}
        right_arm_state = {f"{k}.pos": v for k, v in right_arm_pos.items()}
        head_state = {f"{k}.pos": v for k, v in head_pos.items()}
        dt_ms = (time.perf_counter() - start) * 1e3
        logger.debug(f"{self} read state: {dt_ms:.1f}ms")

        # Capture images from cameras
        camera_obs = self.get_camera_observation()

        # Combine all observations
        obs_dict = {**left_arm_state, **right_arm_state, **head_state, **base_vel, **camera_obs}

        return obs_dict
    
    def get_camera_observation(self):
        obs_dict = {}
        for cam_key, cam in self.cameras.items():
            start = time.perf_counter()
            obs_dict[cam_key] = cam.async_read()
            dt_ms = (time.perf_counter() - start) * 1e3
            logger.debug(f"{self} read {cam_key}: {dt_ms:.1f}ms")
        
        return obs_dict

    def send_action(self, action: dict[str, Any]) -> dict[str, Any]:
        """Command lekiwi to move to a target joint configuration.

        The relative action magnitude may be clipped depending on the configuration parameter
        `max_relative_target`. In this case, the action sent differs from original action.
        Thus, this function always returns the action actually sent.

        Raises:
            RobotDeviceNotConnectedError: if robot is not connected.

        Returns:
            np.ndarray: the action sent to the motors, potentially clipped.
        """
        if not self.is_connected:
            raise DeviceNotConnectedError(f"{self} is not connected.")
        
        left_arm_pos = {k: v for k, v in action.items() if k.startswith("left_arm_") and k.endswith(".pos")}
        right_arm_pos = {k: v for k, v in action.items() if k.startswith("right_arm_") and k.endswith(".pos")}
        head_pos = {k: v for k, v in action.items() if k.startswith("head_") and k.endswith(".pos")}
        base_goal_vel = {k: v for k, v in action.items() if k.endswith(".vel")}
        if not self._base_state_keys and base_goal_vel:
            # No base: the keys are not features, so they are not echoed
            # back either - the recorder would otherwise see a column that
            # the dataset does not have.
            self._warn_no_base(*base_goal_vel.values())
            base_goal_vel = {}
        
        
        if self.config.max_relative_target is not None:
            # Read present positions for left arm, right arm, and head
            present_pos_left = self.bus1.sync_read("Present_Position", self.left_arm_motors)
            present_pos_right = self.bus2.sync_read("Present_Position", self.right_arm_motors)
            present_pos_head = self.bus1.sync_read("Present_Position", self.head_motors)

            # Combine all present positions
            present_pos = {**present_pos_left, **present_pos_right, **present_pos_head}

            # Ensure safe goal position for each arm and head
            goal_present_pos = {
                key: (g_pos, present_pos[key]) for key, g_pos in chain(left_arm_pos.items(), right_arm_pos.items(), head_pos.items())
            }
            safe_goal_pos = ensure_safe_goal_position(goal_present_pos, self.config.max_relative_target)

            # Update the action with the safe goal positions
            left_arm_pos = {k: v for k, v in safe_goal_pos.items() if k in left_arm_pos}
            right_arm_pos = {k: v for k, v in safe_goal_pos.items() if k in right_arm_pos}
            head_pos = {k: v for k, v in safe_goal_pos.items() if k in head_pos}
        
        left_arm_pos_raw = {k.replace(".pos", ""): v for k, v in left_arm_pos.items()}
        right_arm_pos_raw = {k.replace(".pos", ""): v for k, v in right_arm_pos.items()}
        head_pos_raw = {k.replace(".pos", ""): v for k, v in head_pos.items()}
        
        # Only sync_write if there are motors to write to
        if left_arm_pos_raw:
            self.bus1.sync_write("Goal_Position", left_arm_pos_raw)
        if right_arm_pos_raw:
            self.bus2.sync_write("Goal_Position", right_arm_pos_raw)
        if head_pos_raw:
            self.bus1.sync_write("Goal_Position", head_pos_raw)
        if base_goal_vel:
            self._send_base_velocity(
                base_goal_vel.get("x.vel", 0.0),
                base_goal_vel.get("y.vel", 0.0),
                base_goal_vel.get("theta.vel", 0.0),
            )
        return {
            **left_arm_pos,
            **right_arm_pos,
            **head_pos,
            **base_goal_vel,
        }

    def disconnect(self):
        """Stop the base, drop torque, release everything. Never refuse.

        This used to check is_connected first and raise if it was False.
        is_connected requires every camera, so a wrist camera's USB
        dropping out - the one thing that ends a run uninvited - made this
        method raise before it reached stop_base(). STS3215 wheels in
        velocity mode have no watchdog; they run on the last Goal_Velocity
        until power-off. A disconnect that can decline to stop the base is
        not a disconnect.

        Each step now stands alone: it runs if its own device is up, and a
        failure in one does not skip the next.
        """
        problems: list[str] = []

        if self._base_is_connected and (self.bus2.is_connected or self.base_motors == []):
            try:
                self.stop_base()
            except Exception as e:  # noqa: BLE001
                problems.append(f"stop_base: {e}")
            try:
                self._disconnect_base()
            except Exception as e:  # noqa: BLE001
                problems.append(f"base: {e}")

        for name, bus in (("bus1", self.bus1), ("bus2", self.bus2)):
            if bus.is_connected:
                try:
                    bus.disconnect(self.config.disable_torque_on_disconnect)
                except Exception as e:  # noqa: BLE001
                    problems.append(f"{name}: {e}")

        for cam_name, cam in self.cameras.items():
            if cam.is_connected:
                try:
                    cam.disconnect()
                except Exception as e:  # noqa: BLE001
                    problems.append(f"camera {cam_name}: {e}")

        if problems:
            logger.warning(f"{self} disconnected with problems: " + "; ".join(problems))
        else:
            logger.info(f"{self} disconnected.")
