carlkesselman/XLeRobot/software/src/robots/xlerobot_2wheels_odrive/config_xlerobot_2wheels_odrive.py

# Copyright 2024 The HuggingFace Inc. team. All rights reserved.
#
# Licensed under the Apache License, Version 2.0 (the "License");
# you may not use this file except in compliance with the License.
# You may obtain a copy of the License at
#
#     http://www.apache.org/licenses/LICENSE-2.0
#
# Unless required by applicable law or agreed to in writing, software
# distributed under the License is distributed on an "AS IS" BASIS,
# WITHOUT WARRANTIES OR CONDITIONS OF ANY KIND, either express or implied.
# See the License for the specific language governing permissions and
# limitations under the License.

from dataclasses import dataclass, field

from lerobot.cameras.configs import CameraConfig, Cv2Rotation, ColorMode
from lerobot.cameras.opencv.configuration_opencv import OpenCVCameraConfig
from lerobot.cameras.realsense import RealSenseCamera, RealSenseCameraConfig

from lerobot.robots.config import RobotConfig
from lerobot_robot_xlerobot.config_xlerobot import XLerobotConfig


def xlerobot_2wheels_cameras_config() -> dict[str, CameraConfig]:
    return {
        # "left_wrist": OpenCVCameraConfig(
        #     index_or_path="/dev/video0", fps=30, width=640, height=480, rotation=Cv2Rotation.NO_ROTATION
        # ),

        # "right_wrist": OpenCVCameraConfig(
        #     index_or_path="/dev/video2", fps=30, width=640, height=480, rotation=Cv2Rotation.NO_ROTATION
        # ),  

        # "head(RGDB)": OpenCVCameraConfig(
        #     index_or_path="/dev/video2", fps=30, width=640, height=480, rotation=Cv2Rotation.NO_ROTATION
        # ),                     
        
        # "head": RealSenseCameraConfig(
        #     serial_number_or_name="125322060037",  # Replace with camera SN
        #     fps=30,
        #     width=1280,
        #     height=720,
        #     color_mode=ColorMode.BGR, # Request BGR output
        #     rotation=Cv2Rotation.NO_ROTATION,
        #     use_depth=True
        # ),
    }


@RobotConfig.register_subclass("xlerobot_2wheels_odrive")
@dataclass
class XLerobot2WheelsODriveConfig(XLerobotConfig):
    """XLerobotConfig plus the ODrive. Arms, head, cameras, servo profiles and
    the safety fields are inherited, so a knob added to the parent exists here.

    port2 is the right arm only - the wheels are on the ODrive, not that bus.

    `base` defaults to "odrive" here, and may also be "omniwheels" or "none":
    this type can run every configuration the cart has, so one yaml serves
    all three (`--robot.base=none` on the command line, or BASE=none for the
    config/ scripts). With a non-ODrive base the ODrive fields below are
    ignored and the board is never opened.
    """

    cameras: dict[str, CameraConfig] = field(default_factory=xlerobot_2wheels_cameras_config)

    base: str = "odrive"
    _allowed_bases = ("odrive", "omniwheels", "none")

    # Differential drive parameters
    wheel_radius: float = 0.0825  # Wheel radius in metres (165 mm wheel)
    wheelbase: float = 0.25     # Distance between left and right wheel contact points, metres

    # --- ODrive ---------------------------------------------------------
    # Targets ODrive v3.x with 0.5.x firmware - see odrive_base.py. A newer
    # board (S1/Pro, 0.6+) needs that file rewritten, not this config.
    #
    # The two motors face opposite ways when mounted either side of the
    # chassis, so one axis must be negated. Which one depends on the wiring.
    # axis0 (M0) is the RIGHT wheel and axis1 (M1) the LEFT - see
    # odrive_base.RIGHT_AXIS / LEFT_AXIS. `config/odrive-check.sh --spin`
    # shows which way each wheel turns; if driving forward spins the robot
    # in place instead, flip these.
    invert_left_wheel: bool = True
    invert_right_wheel: bool = False

    # Per-wheel clamp, m/s. A safety limit against a runaway command.
    max_linear_mps: float = 1.0
    # Per-wheel acceleration limit, m/s^2, ramped on the ODrive. Smooths
    # teleop's tick-to-tick velocity steps at high gains; also lengthens
    # stops (0.5 s from 0.5 m/s at 1.0). 0 = no ramp.
    max_accel_mps2: float = 1.0
    # Feed-forward torque per wheel (ODrive Nm), measured by
    # config/base_characterize.py: rolling friction, and inertia in Nm per
    # turn/s^2. Either > 0 moves the ramp from the board into odrive_base
    # (see there). 0 / 0 = feedback only, as before.
    friction_ff_nm: float = 0.0
    inertia_ff: float = 0.0

    # The board's own watchdog: this long without a command and the wheels
    # coast. Backstop for a stalled or killed program. 0 = off.
    odrive_watchdog_s: float = 0.5

    odrive_connect_timeout_s: int = 30
    # Set when more than one ODrive is attached; None takes the first found.
    odrive_serial_number: str | None = None

    teleop_keys: dict[str, str] = field(
        default_factory=lambda: {
            # Movement (differential drive)
            "forward": "i",
            "backward": "k",
            "rotate_left": "u",
            "rotate_right": "o",
            # Speed control
            "speed_up": "n",
            "speed_down": "m",
            # quit teleop
            "quit": "b",
        }
    )



@dataclass
class XLerobot2WheelsODriveHostConfig:
    # Network Configuration
    port_zmq_cmd: int = 5555
    port_zmq_observations: int = 5556

    # Duration of the application
    connection_time_s: int = 3600

    # Watchdog: stop the robot if no command is received for over 0.5 seconds.
    watchdog_timeout_ms: int = 500

    # If robot jitters decrease the frequency and monitor cpu load with `top` in cmd
    max_loop_freq_hz: int = 30

@RobotConfig.register_subclass("xlerobot_2wheels_odrive_client")
@dataclass
class XLerobot2WheelsODriveClientConfig(RobotConfig):
    # Network Configuration
    remote_ip: str
    port_zmq_cmd: int = 5555
    port_zmq_observations: int = 5556

    # Differential drive parameters
    wheel_radius: float = 0.0825  # Wheel radius in metres (165 mm wheel)
    wheelbase: float = 0.25     # Distance between left and right wheels in meters

    teleop_keys: dict[str, str] = field(
        default_factory=lambda: {
            # Movement (differential drive)
            "forward": "i",
            "backward": "k",
            "rotate_left": "u",
            "rotate_right": "o",
            # Speed control
            "speed_up": "n",
            "speed_down": "m",
            # quit teleop
            "quit": "b",
        }
    )

    cameras: dict[str, CameraConfig] = field(default_factory=xlerobot_2wheels_cameras_config)

    polling_timeout_ms: int = 15
    connect_timeout_s: int = 5
