carlkesselman/XLeRobot/software/src/robots/xlerobot_2wheels_odrive/xlerobot_2wheels_odrive.py

# Copyright 2024 The HuggingFace Inc. team. All rights reserved.
#
# Licensed under the Apache License, Version 2.0 (the "License");
# you may not use this file except in compliance with the License.
# You may obtain a copy of the License at
#
#     http://www.apache.org/licenses/LICENSE-2.0
#
# Unless required by applicable law or agreed to in writing, software
# distributed under the License is distributed on an "AS IS" BASIS,
# WITHOUT WARRANTIES OR CONDITIONS OF ANY KIND, either express or implied.
# See the License for the specific language governing permissions and
# limitations under the License.

"""XLeRobot with a two-wheel brushless differential base on an ODrive.

Everything that is not the base - two SO-101 arms, the pan/tilt head, the
cameras, calibration, the bus retries, the disconnect ordering, the servo
motion profiles - is inherited from :class:`XLerobot`. This class overrides
only the base hooks, so the two robots cannot drift apart: a fix in the
parent is a fix here.

The hooks apply only when ``config.base == "odrive"``. With ``omniwheels`` or
``none`` every hook defers to the parent, so this one robot type runs all
three of the cart's configurations from one yaml.

(This file used to be a 500-line copy of the parent with the base swapped.
It had none of the hardening the parent gained afterwards.)

The ODrive itself is in :mod:`odrive_base`; this class never sees turns/s.
"""

import logging

import numpy as np

from lerobot.utils.constants import HF_LEROBOT_CALIBRATION, ROBOTS
from lerobot_robot_xlerobot.xlerobot import XLerobot

from .config_xlerobot_2wheels_odrive import XLerobot2WheelsODriveConfig
from .odrive_base import ODriveBase

logger = logging.getLogger(__name__)


class XLerobot2WheelsODrive(XLerobot):
    config_class = XLerobot2WheelsODriveConfig
    name = "xlerobot_2wheels_odrive"

    def __init__(self, config: XLerobot2WheelsODriveConfig):
        # Calibration belongs to the arms and head, not the base, and they
        # are the same servos whichever base is fitted. lerobot files it
        # under robots/<robot.name>/, so without this the robot looks in
        # robots/xlerobot_2wheels_odrive/ and finds nothing - the arm
        # calibration made as `xlerobot` is invisible, every read fails with
        # "has no calibration registered", and an interactive connect()
        # offers to recalibrate from scratch. Share the parent's directory
        # unless the config names one explicitly.
        if config.calibration_dir is None:
            config.calibration_dir = HF_LEROBOT_CALIBRATION / ROBOTS / XLerobot.name

        # The base object must exist before the parent's __init__ runs,
        # because the parent consults the hooks below while building its
        # motor tables, and because a failed parent __init__ still leaves a
        # disconnect() that touches self.base.
        self._odrive = config.base == "odrive"
        self.base = ODriveBase(
            wheel_radius=config.wheel_radius,
            wheelbase=config.wheelbase,
            invert_left=config.invert_left_wheel,
            invert_right=config.invert_right_wheel,
            max_linear_mps=config.max_linear_mps,
            max_accel_mps2=config.max_accel_mps2,
            friction_ff_nm=config.friction_ff_nm,
            inertia_ff=config.inertia_ff,
            watchdog_s=config.odrive_watchdog_s,
            connect_timeout_s=config.odrive_connect_timeout_s,
            serial_number=config.odrive_serial_number,
        ) if self._odrive else None
        super().__init__(config)
        self.config: XLerobot2WheelsODriveConfig = config

    # ------------------------------------------------------------- base hooks
    #
    # Each defers to the parent unless the ODrive is the configured base.

    # _bus2_motors is not overridden: the parent adds wheel ids to bus 2 only
    # for base == "omniwheels", so with the ODrive the bus carries the right
    # arm alone, as it should. One source of truth for the right arm.

    @property
    def _base_state_keys(self) -> tuple[str, ...]:
        if not self._odrive:
            return super()._base_state_keys
        # No y.vel: a differential drive cannot strafe. The operator side
        # must not emit one either (emit_y_vel: false in the leader config),
        # or the robot is sent a key it has no feature for.
        return ("x.vel", "theta.vel")

    @property
    def _base_is_connected(self) -> bool:
        return self.base.is_connected if self._odrive else super()._base_is_connected

    def _connect_base(self) -> None:
        if self._odrive:
            self.base.connect()

    def _disconnect_base(self) -> None:
        if self._odrive:
            self.base.disconnect()

    def _read_base_velocity(self) -> dict[str, float]:
        if not self._odrive:
            return super()._read_base_velocity()
        # The parent's read-retry logic catches ConnectionError, so an ODrive
        # that stops answering mid-run is ridden out on the last good state
        # like a dropped servo packet, rather than ending the episode.
        try:
            return self.base.read_body_velocity()
        except Exception as e:  # noqa: BLE001
            raise ConnectionError(f"ODrive read failed: {e}") from e

    def _send_base_velocity(self, x_mps: float, y_mps: float, theta_degps: float) -> None:
        if not self._odrive:
            return super()._send_base_velocity(x_mps, y_mps, theta_degps)
        if abs(y_mps) > 1e-6:
            # Tolerated, logged once: a stale operator config still emitting
            # y.vel should be loud but not fatal.
            if not getattr(self, "_warned_y", False):
                self._warned_y = True
                logger.warning("%s: received y.vel=%.3f; a differential drive ignores it", self, y_mps)
        self.base.send_body_velocity(x_mps, theta_degps)

    def stop_base(self):
        if not self._odrive:
            return super().stop_base()
        self.base.stop()
        logger.info("Base motors stopped")

    # -------------------------------------------------------------- keyboard

    def _from_keyboard_to_base_action(self, pressed_keys: np.ndarray):
        if not self._odrive:
            return super()._from_keyboard_to_base_action(pressed_keys)
        if self.teleop_keys["speed_up"] in pressed_keys:
            self.speed_index = min(self.speed_index + 1, 2)
        if self.teleop_keys["speed_down"] in pressed_keys:
            self.speed_index = max(self.speed_index - 1, 0)
        speed_setting = self.speed_levels[self.speed_index]
        x_speed = speed_setting["xy"]
        theta_speed = speed_setting["theta"]

        x_cmd = 0.0
        theta_cmd = 0.0
        if self.teleop_keys["forward"] in pressed_keys:
            x_cmd += x_speed
        if self.teleop_keys["backward"] in pressed_keys:
            x_cmd -= x_speed
        if self.teleop_keys["rotate_left"] in pressed_keys:
            theta_cmd += theta_speed
        if self.teleop_keys["rotate_right"] in pressed_keys:
            theta_cmd -= theta_speed

        return {"x.vel": x_cmd, "theta.vel": theta_cmd}
