carlkesselman/XLeRobot/config/servo_tools/power.py

#!/usr/bin/env python
"""Ask the servos what voltage they are actually seeing.

"There is no status packet" from one motor looks the same whether the cause
is a loose connector or a supply that sags when the last few servos
energize. The servos themselves can tell you which: every STS3215 reports
its own bus voltage, temperature and load.

    uv run python config/servo_tools/power.py

Three phases:

  1. everything relaxed      - baseline voltage per motor
  2. torque enabled ONE AT A TIME, re-reading voltage after each
  3. everything holding      - the worst case

If the voltage falls as motors are added, and falls furthest at the end of
a chain, the supply or the wiring is the problem. If it stays flat and one
motor simply stops answering, it is that motor or its connector.

Torque is left DISABLED at the end, and verified by reading the register
back. The arms will probably still hold their pose anyway - an STS3215 gear
train has enough static friction that a de-torqued arm does not flop - so
support them regardless rather than inferring anything from whether it
sagged.
"""

from __future__ import annotations

import argparse
import sys
import time

from lerobot.motors import Motor, MotorNormMode
from lerobot.motors.feetech import FeetechMotorsBus

M = MotorNormMode.RANGE_M100_100

from .hw import JOINTS, PORTS

BUS1 = {name: mid for mid, name in JOINTS[1].items()}
BUS2 = {name: mid for mid, name in JOINTS[2].items()}
P1 = PORTS[1]
P2 = PORTS[2]

# STS3215 reports voltage in tenths of a volt. Nominal supply is 12 V; the
# datasheet floor is around 9. Current is in raw counts - the scaling is not
# documented consistently, so it is shown unconverted and used only to
# compare motors with each other.
def volts(raw): return raw / 10.0


BUS_RETRY = 3


def read1(bus, name, reg):
    try:
        return bus.read(reg, name, num_retry=2)
    except Exception:
        return None


def limits(bus, motors, label):
    """What the servos themselves consider acceptable.

    Saves having to know which STS3215 variant is fitted: the motor stores
    its own Min/Max_Voltage_Limit, so Present_Voltage can be judged against
    the part rather than against a guess.
    """
    print(f"\n  {label}")
    seen = set()
    for name in motors:
        lo = read1(bus, name, "Min_Voltage_Limit")
        hi = read1(bus, name, "Max_Voltage_Limit")
        if lo is None or hi is None:
            continue
        seen.add((lo, hi))
    for lo, hi in sorted(seen):
        print(f"    the servos accept {volts(lo):.1f} - {volts(hi):.1f} V")
    return min((lo for lo, _ in seen), default=None)


def table(bus, motors, label):
    print(f"\n  {label}")
    print(f"    {'motor':<26}{'volts':>8}{'temp C':>8}{'load':>8}{'current':>9}")
    lo, lo_name = None, None
    for name in motors:
        v = read1(bus, name, "Present_Voltage")
        t = read1(bus, name, "Present_Temperature")
        ld = read1(bus, name, "Present_Load")
        cu = read1(bus, name, "Present_Current")
        if v is None:
            print(f"    {name:<26}{'NO ANSWER':>8}")
            continue
        if lo is None or v < lo:
            lo, lo_name = v, name
        print(f"    {name:<26}{volts(v):>8.1f}{t if t is not None else '-':>8}"
              f"{ld if ld is not None else '-':>8}{cu if cu is not None else '-':>9}")
    if lo is not None:
        print(f"    lowest: {volts(lo):.1f} V at {lo_name}")
    return lo


def progressive(bus, motors, label):
    """Enable torque one motor at a time, watching the voltage fall."""
    print(f"\n  {label} - enabling torque one at a time")
    print(f"    {'after enabling':<26}{'its volts':>11}{'bus min':>10}")
    worst = None
    for name in motors:
        try:
            bus.enable_torque([name], num_retry=2)
        except Exception as e:
            print(f"    {name:<26}{'FAILED':>11}   {type(e).__name__}")
            print(f"      {e}")
            continue
        time.sleep(0.25)          # let the holding current settle
        v = read1(bus, name, "Present_Voltage")
        allv = [x for x in (read1(bus, n, "Present_Voltage") for n in motors) if x]
        mn = min(allv) if allv else None
        if mn is not None and (worst is None or mn < worst):
            worst = mn
        print(f"    {name:<26}{volts(v) if v else '-':>11}"
              f"{volts(mn) if mn else '-':>10.1f}")
    return worst


def any_answer(port, motors) -> bool:
    """True if at least one of these motors pings. Opens and closes the port."""
    bus = FeetechMotorsBus(port, {n: Motor(i, "sts3215", M) for n, i in motors.items()})
    try:
        bus.connect(handshake=False)
    except Exception:
        return False
    try:
        for name in motors:
            if read1(bus, name, "Present_Voltage") is not None:
                return True
        return False
    finally:
        try:
            bus.disconnect(disable_torque=False)
        except Exception:
            pass


def run(port, motors, label):
    bus = FeetechMotorsBus(port, {n: Motor(i, "sts3215", M) for n, i in motors.items()})
    print(f"\n{'=' * 64}\n{label}\n  {port}\n{'=' * 64}")
    try:
        bus.connect(handshake=False)   # a flaky motor must not stop the survey
    except Exception as e:
        print(f"  could not open: {e}")
        return None

    try:
        bus.disable_torque(num_retry=2)
    except Exception as e:
        print(f"  (could not relax everything first: {e})")
    time.sleep(0.3)

    floor = limits(bus, motors, "0. what the servos will accept")
    rest = table(bus, motors, "1. relaxed")
    if rest is not None and floor is not None and rest < floor:
        print(f"\n    *** {volts(rest):.1f} V IS BELOW THE SERVOS' OWN MINIMUM "
              f"OF {volts(floor):.1f} V ***")
        print("    Nothing downstream of this will be reliable. Stop here and")
        print("    fix the supply; the rest of the test only measures how bad.")
    worst = progressive(bus, motors, "2. progressive")
    held = table(bus, motors, "3. all holding")

    # Verify rather than assert. The cleanup used to be wrapped in a bare
    # except/pass, so a failed disable looked exactly like a successful one.
    # And a de-torqued STS3215 arm usually does NOT flop - the gear train
    # has enough static friction to hold a pose - so "it did not go limp"
    # is not evidence either way. Read the register back instead.
    try:
        bus.disable_torque(num_retry=BUS_RETRY)
    except Exception as e:
        print(f"\n  WARNING: could not disable torque: {e}")

    still_on = []
    for name in motors:
        v = read1(bus, name, "Torque_Enable")
        if v:
            still_on.append(name)
        elif v is None:
            still_on.append(f"{name}(no answer)")
    if still_on:
        print(f"\n  STILL ENERGISED: {', '.join(still_on)}")
        print("  Power them down before working on the arm.")
    else:
        print("\n  torque confirmed off on every motor "
              "(they may still hold their pose - the gearing is stiff)")

    bus.disconnect()
    return rest, worst, held


def main() -> int:
    ap = argparse.ArgumentParser(description=__doc__,
                                 formatter_class=argparse.RawDescriptionHelpFormatter)
    ap.add_argument("--port1", default=P1)
    ap.add_argument("--port2", default=P2)
    args = ap.parse_args()

    print(__doc__.strip().splitlines()[0])
    print("\nArms will go limp at the end. Support them before continuing.")
    try:
        input("ENTER to start, Ctrl-C to abandon: ")
    except (EOFError, KeyboardInterrupt):
        return 1

    r1 = run(args.port1, BUS1, "BUS 1   left arm 1-6 + head 7-8")
    # Bus 2 carries the omniwheels (ids 7-9) only with the servo base. With
    # the ODrive base they are simply absent; probe first so the survey does
    # not print three rows of "no answer" and call it a fault.
    bus2 = dict(BUS2)
    wheel_names = [n for n in bus2 if n.startswith("base_")]
    if wheel_names and not any_answer(args.port2, {n: bus2[n] for n in wheel_names}):
        print(f"\n  (no servo wheels on bus 2 - expected with base: odrive or none; surveying the arm only)")
        for n in wheel_names:
            bus2.pop(n)
    r2 = run(args.port2, bus2, "BUS 2   right arm 1-6" + (" + base wheels 7-9" if wheel_names and len(bus2) > 6 else ""))

    print(f"\n{'=' * 64}\nREADING THIS\n{'=' * 64}")
    for label, r in (("bus1", r1), ("bus2", r2)):
        if not r:
            continue
        rest, worst, held = r
        if rest and worst:
            print(f"  {label}: {volts(rest):.1f} V relaxed -> {volts(worst):.1f} V worst "
                  f"(sag {volts(rest) - volts(worst):.1f} V)")
    print("""
  Compare the relaxed voltage against the range the servos reported. A
  plain USB-C port with no PD negotiation supplies 5 V, which is below
  what an STS3215 needs - it is enough for the logic to answer a scan and
  enough to move one joint under light load, but not enough when six
  energize together. That failure looks exactly like a dead servo.

  A sag of a few tenths is normal. A volt or more, or any motor below
  about 9 V, is a supply that cannot hold up the whole robot - and the
  motor that stops answering will be the one at the end of the longest
  cable run, which is why it looks like a bad servo.

  Flat voltage with one motor silent means that motor or its connector,
  not the supply.

  Rising temperature on one motor while its neighbours stay cool means it
  is fighting something mechanical.
""")
    return 0


if __name__ == "__main__":
    raise SystemExit(main())
