carlkesselman/XLeRobot/config/servo_tools/scan.py

#!/usr/bin/env python
"""Probe both Feetech buses and say which xlerobot motors actually answer.

Run this BEFORE calibrating anything, and again after moving hardware to a
new machine. It is the only way to tell "the head servos are not wired yet"
apart from "the head servos are wired and one is dead" - both of which
surface later as the same unhelpful "no status packet" during connect.

    uv run python config/servo_tools/scan.py
    uv run python config/servo_tools/scan.py --port1 /dev/ttyACM0

Nothing is written. The scan only pings, and it sweeps every supported baud
rate, so a motor left on the wrong baud rate shows up here rather than
vanishing.
"""

from __future__ import annotations

import argparse
import sys

from lerobot.motors.feetech import FeetechMotorsBus

# What XLerobot expects, from xlerobot.py. Keep in step with it.
from .hw import JOINTS, PORTS

BUS1 = JOINTS[1]
BUS2 = JOINTS[2]
DEFAULT_PORT1 = PORTS[1]
DEFAULT_PORT2 = PORTS[2]

# What lerobot configures motors to. A motor answering anywhere else needs
# setting up, not calibrating. Read from the class rather than hardcoded so
# an upstream change cannot make this quietly wrong.
EXPECTED_BAUD = FeetechMotorsBus.default_baudrate


def diagnose_port(port: str) -> list[str]:
    """Say why a port cannot be opened. 'Make sure you are using the correct
    port' is lerobot's answer to every failure here, and it is wrong more
    often than it is right - the port is usually correct and something else
    is in the way."""
    import glob
    import grp
    import os
    import subprocess

    notes: list[str] = []

    if not os.path.exists(port):
        notes.append("The path does not exist. Present now:")
        for p in sorted(glob.glob("/dev/serial/by-id/*")) or ["(none)"]:
            notes.append(f"  {p}")
        notes.append("")
        notes.append("A half-seated USB cable looks exactly like a wrong path.")
        return notes

    real = os.path.realpath(port)
    st = os.stat(real)
    owner_group = grp.getgrgid(st.st_gid).gr_name
    notes.append(f"{port}")
    notes.append(f"  -> {real}  {owner_group}  {oct(st.st_mode & 0o777)}")

    if not os.access(real, os.R_OK | os.W_OK):
        mine = {g.gr_name for g in grp.getgrall() if os.getlogin() in g.gr_mem}
        notes.append("")
        notes.append(f"  PERMISSION DENIED. You are not in '{owner_group}'.")
        notes.append(f"    sudo usermod -aG {owner_group} $USER")
        notes.append("  then LOG OUT AND BACK IN - group membership is set at")
        notes.append("  login, so a new shell in the same session will not have it.")
        notes.append(f"  (your groups: {' '.join(sorted(mine)) or 'unknown'})")
        return notes

    notes.append("  Permissions are fine, so something else holds the port.")
    try:
        mm = subprocess.run(
            ["systemctl", "is-active", "ModemManager"], capture_output=True, text=True, timeout=5
        ).stdout.strip()
    except Exception:
        mm = "unknown"
    if mm == "active":
        notes.append("")
        notes.append("  ModemManager is RUNNING. It probes every new CDC-ACM device")
        notes.append("  and holds it open for ~20s talking AT commands at it, which")
        notes.append("  looks identical to a permissions failure. See config/README.md")
        notes.append("  for the udev rule that makes it ignore these adapters.")
    else:
        notes.append("  ModemManager is not running, so look for a stale process:")
        notes.append(f"    sudo lsof {real}")
    return notes


def scan(port: str, expected: dict[int, str], label: str) -> tuple[set[int], bool]:
    print(f"\n{'=' * 68}\n{label}\n  {port}\n{'=' * 68}")
    try:
        found = FeetechMotorsBus.scan_port(port)
    except Exception as e:
        print(f"  ERROR: could not open the port.\n  {e}\n")
        for line in diagnose_port(port):
            print(f"  {line}")
        # Not a baud-rate verdict - we never got far enough to have one.
        return set(), True

    if not found:
        print("  Nothing answered at any baud rate.")
        print("  Power off? Wrong port? Bus not terminated at the first servo?")
        return set(), False

    ids: set[int] = set()
    baud_ok = True
    for baud, id_list in sorted(found.items()):
        mark = "" if baud == EXPECTED_BAUD else "   <- NOT the baud rate lerobot uses"
        print(f"  {baud:>9} baud: {sorted(id_list)}{mark}")
        if baud != EXPECTED_BAUD:
            baud_ok = False
        ids |= set(id_list)

    print()
    width = max(len(n) for n in expected.values())
    for mid, name in sorted(expected.items()):
        print(f"    id {mid:<2}  {name:<{width}}  {'present' if mid in ids else 'MISSING'}")

    extra = sorted(ids - set(expected))
    if extra:
        print(f"\n    unexpected ids: {extra}")
        print("    Another servo on this bus, or one left on a stale id.")

    return ids, baud_ok


def main() -> int:
    ap = argparse.ArgumentParser(description=__doc__, formatter_class=argparse.RawDescriptionHelpFormatter)
    ap.add_argument("--port1", default=DEFAULT_PORT1, help="left arm + head bus")
    ap.add_argument("--port2", default=DEFAULT_PORT2, help="right arm + base bus")
    args = ap.parse_args()

    ids1, baud1 = scan(args.port1, BUS1, "BUS 1   left arm (1-6) + head (7-8)")
    ids2, baud2 = scan(args.port2, BUS2, "BUS 2   right arm (1-6) [+ omniwheels 7-9 if that base]")

    arms = {1, 2, 3, 4, 5, 6}
    head = {7, 8}
    wheels = {7, 8, 9}

    have_arms = arms <= ids1 and arms <= ids2
    have_head = head <= ids1
    have_servo_wheels = wheels <= ids2

    print(f"\n{'=' * 68}\nWHAT YOU CAN RUN\n{'=' * 68}")
    print(f"  both arms      {'yes' if have_arms else 'no'}")
    print(f"  head           {'yes' if have_head else 'no'}")
    print(f"  servo wheels   {'yes' if have_servo_wheels else 'no  (expected with base: odrive or none)'}")
    print()

    if have_arms and have_head:
        if have_servo_wheels:
            print("  Full xlerobot with the 3-omni servo base:")
            print("    --robot.type=xlerobot")
        else:
            print("  Arms and head complete; no servo wheels on bus 2. That is the")
            print("  layout for a cart without servo wheels:")
            print("    --robot.type=xlerobot_2wheels_odrive  with base: odrive (wheels on USB) or none")
            print("  The ODrive is found over USB, not scanned here - lsusb should")
            print("  show 1209:0d32 (ODrive / ODESC).")
        print("\n  Calibrate (same calibration file either way; the wheels are not in it):")
        print(f"    lerobot-calibrate --robot.type=<type above> --robot.id=xlerobot \\")
        print(f"      --robot.port1={args.port1} \\")
        print(f"      --robot.port2={args.port2}")
        print("\n  Then: ./config/cart-selftest.sh")
    elif have_arms:
        print(f"  Arms only - head (bus1 ids {sorted(head - ids1)}) not responding.")
        print("  The robot reads the head with the left arm and will fail on connect.")
        print("  Wire it first. (A missing base is fine: BASE=none.)")
        print("\n  To bring a new servo onto a bus, set its id first, with it alone on the bus:")
        print("    ./config/servo.sh set-id --bus N --id M")
    else:
        print("  Arms incomplete. Fix that before anything else.")
        print("  A whole bus silent is usually the cable or power; one id")
        print("  silent is usually that servo or its daisy-chain link.")

    if not (baud1 and baud2):
        print("\n  WARNING: something answered at a non-default baud rate.")
        print(f"  lerobot talks at {EXPECTED_BAUD}. Re-run lerobot-setup-motors for those.")

    # The servo wheels are optional - base: odrive and none have none - so
    # success is arms and head. (This used to name a have_base that was
    # renamed away when the ODrive base arrived, and raised on every clean
    # scan.)
    return 0 if (have_arms and have_head) else 1


if __name__ == "__main__":
    sys.exit(main())
