carlkesselman/XLeRobot/(commit log)

2026-10-06 Unpack xlerobot_urdf.zip into simulation/xlerobot/ (#150)
    The STLs are already binary/compressed, so zipping them doesn't save
    disk space, but it does prevent using the URDF directly from code
    (e.g. as a package data path) without an extra unzip step. Nothing
    in the repo references the zip path, and other URDF assets
    (Maniskill) are already stored unpacked, so this just makes the
    xlerobot URDF consistent with the rest of the repo.
    [Base.stl, Base_Motor.stl, Fixed_Jaw.stl, Fixed_Jaw_Motor.stl, Fixed_Jaw_part1.ply.convex.stl, Fixed_Jaw_part2.ply.convex.stl, Lower_Arm.stl, Lower_Arm_Motor.stl]
2026-10-06 Package robots and the VR teleoperator as lerobot plugins (#151)
    xlerobot, xlerobot_2wheels, xlerobot_mecanum, and the xlerobot_vr
    teleoperator now install into lerobot as plugins via lerobot's own
    register_third_party_plugins() mechanism, instead of being copied into
    lerobot's src/lerobot/ tree. Each one gets a small package under
    software/plugins/ (a pyproject.toml plus a symlink back to the existing
    software/src/ code, nothing moved).
    Once installed with pip, --robot.type=xlerobot / xlerobot_2wheels /
    xlerobot_mecanum and --teleop.type=xlerobot_vr work on any lerobot CLI
    command with no extra setup.
    Fixed a few bugs this exposed:
    - All four modules used relative imports (from ..robot im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
    [4_xlerobot_2wheels_teleop_keyboard.py, 4_xlerobot_teleop_keyboard.py, 5_xlerobot_teleop_xbox.py, 7_xlerobot_2wheels_teleop_joycon.py, 7_xlerobot_2wheels_teleop_joycon_smooth.py, 7_xlerobot_teleop_joycon.py]
2026-10-08 Allow mecanum host config to be set from the command line
    Apply the same argparse front end to the mecanum host, which hardcoded
    its id and ports in the same way. Defaults preserve the existing values,
    including the swapped port1/port2 ordering specific to this variant.
    [xlerobot_host.py]
2026-10-08 fix(xlerobot): export the client and host so the plugin can instantiate them
    The client and host imports were commented out in the xlerobot package
    __init__. lerobot resolves a plugin's device class by stripping 'Config'
    from the config class name and importing from a short candidate list
    (make_device_from_device_class in lerobot.utils.import_utils):
    XLerobotClientConfig -> XLerobotClient, searched in
    lerobot_robot_xlerobot.config_xlerobot (configs only)
    lerobot_robot_xlerobot (<- this __init__)
    lerobot_robot_xlerobot.xlerobotclient (file is xlerobot_client.py)
    lerobot_robot_xlerobot.xlerobot (defines XLerobot)
    Only the package __init__ can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
2026-10-08 feat: xlerobot_2wheels_odrive - brushless 2-wheel base on an ODrive
    xlerobot_2wheels with the base swapped from two Feetech servos to two
    ODrive axes. Arms, head, cameras, action space and the ZMQ host/client are
    unchanged, so datasets and policies stay interchangeable with the servo
    variant.
    bus1 left arm 1-6 + head 7-8 Feetech
    bus2 right arm 1-6 only Feetech (no wheels on this bus)
    ODrive axis0/axis1 = left/right wheel
    Action and observation space is unchanged: 14 joints + x.vel (m/s) and
    theta.vel (deg/s), no y.vel.
    All ODrive-specific code is in odrive_base.py, which targets v3.x with
    0.5.x firmware - the API the scripts under software/examples/odrive use
    (find_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
    [config_xlerobot_2wheels_odrive.py, odrive_base.py, xlerobot_2wheels_odrive.py, xlerobot_2wheels_odrive_client.py, xlerobot_2wheels_odrive_host.py]
2026-10-08 feat(xlerobot): --config_path on the host, so it can serve cameras
    The host builds XLerobotConfig from individual argparse flags, which cannot
    express the cameras dict - so a host started this way streams joint state
    only, however many cameras the robot has. The frame-encoding loop was
    already there; it just had nothing to iterate.
    --config_path loads the whole XLerobotConfig from YAML via draccus, which
    resolves each camera's type: discriminator through the CameraConfig
    registry. The flags still work when no config file is given, and now log a
    warning saying cameras are off.
    [xlerobot_host.py]
2026-10-08 feat: xlerobot_leader_gamepad - leader arms + gamepad as one teleoperator
    Driving XLeRobot needs two input devices: leader arms for the twelve arm
    joints, something else for the head and base. lerobot's record and
    teleoperate CLIs take exactly one teleoperator. record_loop does have a
    multi-teleop path, but it is gated to robot.name == 'lekiwi_client' and to
    the single-arm leader classes, so it cannot serve this robot - which is why
    XLeRobot's own keyboard examples are standalone loops that never record.
    Presenting both devices as ONE teleoperator sidesteps the gate and works
    with the stock CLI, so recording needs no patched lerobot.
    Gamepad rather than keyboard: lerobot's keyboard teleope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
2026-10-08 feat: serve the leader arms over the network
    The cart carries the Orin, so the robot, the cameras, the dataset and
    eventually the policy are all on one machine. That makes the LEADERS the
    remote device rather than the robot - the mirror image of lekiwi, and of
    xlerobot_host/xlerobot_client.
    New plugin lerobot_teleoperator_xlerobot_leader_remote, two halves:
    leader_host.py operator station. Wraps the existing
    xlerobot_leader_gamepad and publishes each
    action over ZMQ PUSH+CONFLATE.
    XLerobotLeaderRemote cart, inside lerobot-record. PULL+CONFLATE,
    registered xlerobot_leader_remote.
    Design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
2026-10-09 fix: XLerobot.connect() prompted even when it had no question to ask
    connect(calibrate=False) still ran
    input('Press ENTER to restore calibration from file, or type c ...')
    because the prompt was never gated on the flag. Interactively it is a
    keystroke; non-interactively it is a hang with no output explaining why -
    a scheduled recording, a systemd unit, or anything with a pipe for stdin
    waits forever on a question nobody can see.
    Now it asks only when calibrate is true AND stdin is a tty. Otherwise it
    restores from file silently, which is what calibrate=False already meant.
    Claude-Session: https://claude.ai/code/session_01FxiD7CRg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
    [xlerobot.py]
2026-10-09 fix: composite teleoperator looked for calibration nobody has
    XLerobotLeaderGamepad passed id=f'{config.id}_leaders' to BiSOLeader, which
    appends _left / _right itself. With id: xlerobot_leaders that resolves to
    xlerobot_leaders_leaders_left
    xlerobot_leaders_leaders_right
    while the leaders are actually calibrated as xlerobot_leaders_left and
    _right, from config/bi-arms.yaml on the Pi. The first run would have
    demanded a fresh calibration of both leader arms for no reason.
    Passing config.id through means this teleoperator shares per-arm
    calibration with bi_so_leader - calibrate the leaders once, drive from
    either config.
    Found by reading, not by running: the leaders are still on t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
2026-10-09 feat: 'jetson' extra routes torch to the cu132 index
    uv sync --extra jetson on elroy; plain uv sync everywhere else.
    Extra-gated index selection per uv's PyTorch guide: [tool.uv.sources] keyed
    by extra, with an explicit=true index so cu132 only answers for torch and
    torchvision.
    uv.lock is NOT regenerated here - download.pytorch.org is unreachable from
    this machine. Run uv lock on elroy or rosie.
    Claude-Session: https://claude.ai/code/session_01FxiD7CRg78PvZpVEApAz3C
2026-10-09 fix: scope the jetson torch index to aarch64
    Without a marker it claimed torch on x86_64 linux too, where the fork
    already routes to cu128, and uv refused to resolve:
    Requirements contain conflicting indexes for package torch in split
    '... platform_machine == x86_64 and sys_platform == linux'
    Scoping to aarch64 leaves x86_64 to the fork's entry, and says what was
    true anyway - this extra exists for the Jetson.
    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
2026-10-09 fix: the jetson torch marker needed sys_platform too
    No solution found ... for split (markers: platform_machine == 'aarch64'
    and sys_platform == 'win32')
    uv resolves for every environment it can imagine unless told otherwise,
    including ARM64 Windows. A machine-only marker handed torch to cu132 there
    while the fork's non-ARM pin applied, so the lock failed on a platform
    nobody will ever run this on.
    Now scoped to linux aarch64, which is what the extra was always for.
    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
2026-10-09 fix: let SDL start without a display
    The leader host runs headless by design - rosie is an SSH session with no
    DISPLAY - but pygame.init() brings up SDL's video subsystem and fails there
    with 'No available video device'. The gamepad is read over /dev/input and
    needs no video at all.
    Both the probe and the teleoperator now set SDL_VIDEODRIVER=dummy when
    neither DISPLAY nor WAYLAND_DISPLAY is set.
    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
2026-10-09 feat: guided gamepad probe that emits the config
    The probe crashed on its own output line:
    TypeError: unsupported format string passed to dict.__format__
    f'{live:<40}' where live is a dict. But patching the crash would have left
    the real problem: reading indices off a flickering \r line and typing them
    into a YAML by hand is how a silent misconfiguration happens, and a wrong
    axis number does not fail - the cart just drives sideways.
    Default mode now walks through each control one at a time, waits for
    everything to return to rest between steps so one control cannot bleed into
    the next reading, takes the largest displacement from rest rather than the
    first thing over a threshold, and prin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
2026-10-09 feat: tap the leader stream with no robot attached
    Everything between the leader arms and the cart, on its own: the ZMQ link,
    XLerobotLeaderRemote itself, the action key set, and whether moving a
    leader actually changes what arrives. The robot is the expensive part to
    get wrong, so prove the rest first.
    It uses the real client class rather than a reimplementation, so what it
    exercises is exactly what lerobot-record will run - including the receive
    thread, the staleness watchdog and the key derivation.
    The summary is the point: which keys ever changed and which never did. A
    key that never moves is a control not reaching the cart, and that is a
    failure with no error message attached - the sa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
2026-10-09 fix: the leader host was running silently
    Output stopped after pygame's banner, so a working host looked exactly like
    one that hung during startup.
    logging.basicConfig is a no-op once the root logger has handlers, and
    importing lerobot installs them - so every logger.info in this script went
    nowhere, including 'Publishing actions on tcp://*:5557', which is the one
    line that answers 'is it alive?'.
    The status lines now go to stdout with flush, so they survive whatever
    logging configuration lerobot has installed, and the root level is forced
    to INFO as well. It also prints the action key list on startup, which is
    the other thing worth seeing before connecting the cart - 12 keys means
    arms on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
2026-10-09 fix: retry the bus writes in configure(), they were single-shot
    ConnectionError: Failed to write 'Torque_Enable' on id_=6 with '1'
    after 1 tries. [TxRxResult] There is no status packet!
    Seventeen servos daisy-chained at 1 Mbaud drop a packet occasionally. That
    is the medium, not a fault - but enable_torque/disable_torque default to
    num_retry=0, so a single lost reply during configure() aborts the entire
    connect.
    Measured before changing anything, with config/power-check.sh:
    - every one of the 17 motors answers, including the one that failed
    - 12.0-12.2 V across both buses, against a 4.0-14.0 V window the servos
    report for themselves
    - ZERO sag enabling torque one motor at a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
    [xlerobot.py]
2026-10-09 feat: head can live on the D-pad instead of a held modifier
    A 3-omni base uses three stick axes - forward, strafe, turn - leaving one
    short for a pan-tilt head, which is why the head borrowed the right stick
    behind a held L1. A hat removes the conflict entirely.
    hat_head (default 0) takes pan and tilt from the hat; the right stick then
    never stops turning and button_head_modifier goes unused. Set it to -1 for
    the old scheme. If the pad reports fewer hats than configured, it warns
    once and falls back rather than silently losing head control.
    invert_hat_tilt defaults true because the hat reports +1 for up while
    head_motor_2 has to decrease to raise the head on this robot.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
2026-10-09 fix: put the leader link in the voice queue, and make it notice a dead peer
    The link stalled ~300 ms about once a second whenever the cart was also
    streaming video to the operator's viewer, and never otherwise. The cart's
    Python was exonerated by its own cadence: the control loop held 29.5 Hz
    through the stalls, which a 300 ms GIL or GC freeze cannot do. The bytes
    were late on the wire.
    Mechanism: the cart's uplink carries the video; the cart's TCP ACKs back
    to the operator queue behind seconds of it; the operator's action flow is
    60 packets/s and application-limited, so its congestion window is pinned
    at the initial 10 segments, and after ~10 unacknowledged messages its
    kernel stops sendin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
2026-10-09 fix: give the head servos a motion profile
    The head is commanded as absolute positions ~1 unit apart at 30 Hz when
    the D-pad is held - the operator integrates a rate at 60 Hz, the robot
    samples the conflated latest at 30, so each tick advances 1.0 nominal
    with 0.5/1.5 as the two clocks beat. configure_motors() leaves every
    servo at Acceleration=254 with no speed limit, so each step was a
    full-torque jump and a hold: thirty nudges a second. The arms get the
    same treatment and hide it behind a human hand and their own inertia; a
    light pan/tilt carrying the camera you watch through hides nothing.
    Goal_Velocity (steps/s) and Acceleration (100 steps/s^2) on the two head
    servos only, exposed as h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
    [config_xlerobot.py, xlerobot.py]
2026-10-09 fix: a corrupted reply no longer ends the run
    get_observation() issued four sync_reads per tick with num_retry=0. One
    "[TxRxResult] Incorrect status packet!" on bus 2 - which happened on the
    second tick of a run - raised ConnectionError out of the control loop,
    ending the session and, via the disconnect path, risking a base left
    driving. At ~90 transactions a second a dropped reply over a 30-minute
    recording is a certainty, not a risk.
    Three reads instead of four: bus 1's left arm and head share one
    Present_Position sync_read. Every read retries BUS_RETRY times. If the bus
    is still not answering, the last good state is reused for up to ten ticks
    (a third of a second) with a warning, then it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
    [xlerobot.py]
2026-10-09 fix: disconnect() always stops the base; never fall through to recalibration
    disconnect() checked is_connected first and raised if it was False.
    is_connected requires every camera, so a wrist camera's USB dropping
    out - the one thing that ends a run uninvited - made the method raise
    before it reached stop_base(). STS3215 wheels in velocity mode have no
    watchdog; they run on the last Goal_Velocity until power-off. Now each
    step runs if its own device is up, and a failure in one does not skip
    the next.
    connect() responded to a transient write failure during calibration
    restore by calling calibrate() - a destructive manual procedure where one
    reflexive ENTER rewrites Homing_Offset in every mot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
2026-10-11 fix: cap arm acceleration, which caps the start-up inrush
    With both servo buses on one supply, the first tick of a teleop run took
    both buses down: bus 2 answered garbage on the first send_action(), and
    within two seconds neither bus answered at all. The self-test a minute
    earlier - torque on, holding, nothing commanded - had passed at 30.8 Hz,
    and power-check showed 13.4 V with no sag. The difference is the command:
    send_action() hands all twelve arm servos a goal at once, the followers
    snap toward wherever the leaders are, and configure_motors() had left
    every one at Acceleration=254. Twelve STS3215s starting from rest at
    maximum acceleration is the largest current spike this robot produce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
2026-10-11 refactor: the ODrive robot is a subclass of XLerobot, not a copy
    xlerobot_2wheels_odrive.py was a 500-line copy of xlerobot.py with the
    base swapped. It had none of the hardening the parent gained since: no
    retry on the per-tick reads, the old disconnect() that could skip
    stop_base() when a camera dropped, the fall-through to destructive manual
    calibration on a dropped packet, no head motion profile, no arm
    acceleration cap. That is how two robots drift apart.
    XLerobot now routes everything the base contributes through hooks -
    _bus2_motors, _base_state_keys, _base_is_connected, _connect_base,
    _disconnect_base, _read_base_velocity, _send_base_velocity, stop_base -
    with the three Feetech omni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
2026-10-11 fix: re-arm the ODrive axes when something knocks them out of closed loop
    An ODrive that loses its DC bus and gets it back boots to IDLE. USB
    returns, reads answer, input_vel is accepted and ignored: a base that is
    silently dead with no error anywhere. With the drive on a drill pack
    behind a low-voltage disconnect that auto-reconnects, that is not a
    corner case but the expected end of every charge; a bouncing battery
    contact or a latched fault does the same.
    read_body_velocity() now checks both axes' current_state every tick and,
    if either has left closed loop, clears errors and requests it again -
    once per two seconds, with the states, error words and vbus in the log,
    so an axis that will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
2026-10-11 odrive base: save ODESC wiring diagram, fix install note
    Vendor wiring diagram for the ODESC (terminal layout, encoder/Hall header
    pinout) kept next to the driver. README install section updated: the
    plugin is a default dependency now, not the odrive group.
    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
2026-10-11 leader remote: soak, a graded link test with no robot
    Raw PULL with the client's socket tuning, every message timed for N
    minutes: inter-arrival histogram, stalls at the 300 ms stale threshold,
    lost sequence numbers, one-way delay spread. Run quiet and under
    video-test load; a stall count that appears only under load means the
    TOS marking is not honoured at some hop.
    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
2026-10-12 xlerobot: base = odrive | omniwheels | none, one field for three carts
    XLerobotConfig.base picks the base. The parent's hooks implement
    omniwheels (the stock ids 7-9 on bus 2) and none (right arm only on bus 2,
    no .vel features, base commands dropped with one warning, stop_base and
    the keyboard mapping no-ops). XLerobot2WheelsODrive defaults to odrive and
    defers every hook to the parent for the other two, so
    type: xlerobot_2wheels_odrive runs all three configurations from one yaml
    and --robot.base=<which> switches at the command line. Each config class
    validates against its own allowed set.
    Also fixes a bug from 73696ad: the @property on _state_ft was separated
    from its def when the base ho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
2026-10-15 fix: the ODrive robot uses the arms' calibration, filed under xlerobot
    lerobot files calibration under robots/<robot.name>/<id>.json. The arms
    were calibrated as type xlerobot; since the cart switched to
    xlerobot_2wheels_odrive (73696ad era) the robot looked in
    robots/xlerobot_2wheels_odrive/, found nothing, connected with
    calibrate=False, and failed the first read with 'has no calibration
    registered'. An interactive connect would instead have offered a full
    manual recalibration.
    Calibration belongs to the arms and head, which are the same servos
    whatever base is fitted, so default calibration_dir to the parent's
    directory unless the config sets one.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
2026-10-16 lock: from elroy - odrive, torch 2.12, torchcodec 0.12
2026-10-16 build: lockable on the Mac; torchcodec 0.12 for the Jetson's torch
    - [[tool.uv.dependency-metadata]] for odrive 0.5.4. It ships as source
    only and its setup.py loads a native library that refuses macOS, so uv
    could not learn its dependencies and 'uv lock' only worked on elroy. The
    requirement list is read off the package installed there.
    - torchcodec>=0.12,<0.13 on aarch64 linux in the jetson extra. One
    resolution served rosie (torch 2.11) and elroy (torch 2.12+cu132), and
    uv kept torchcodec 0.11.1 for both, which fails to load on elroy
    ('Could not load libtorchcodec'). The jetson extra already forks the
    resolution, so the Jetson now gets its own.
    uv.lock is not updated here: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
2026-10-16 lock: torchcodec 0.12 for the Jetson
2026-10-16 config: move the cart's configuration and tools here from the lerobot fork
    Everything in config/ is about this robot - serial ports, joint ids,
    cameras, rosie's IP, the run scripts and their docs - and this repo is
    already the uv workspace every one of them ran through via
    'uv run --project ../XLeRobot'. It moves verbatim from lerobot
    feature/xlerobot (history before this commit is there, last at 68b33ad04),
    with only the path logic changed:
    - _common.sh: REPO and the workspace are now the same directory; it
    checks for the lerobot fork as a sibling (../lerobot) instead of the
    other way round.
    - 'uv run --project ../XLeRobot' in docs and docstrings is now 'uv run';
    'cd ~/GitHub/lerobot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
2026-10-19 odrive-check: motor bring-up - halls, setup-motors, calibrate, spin
    The two hub-motor wheels are fitted (2026-10-19). Four steps, in order:
    --halls count Hall edges over one hand-turned revolution per
    wheel: pole pairs = edges/6, no current, and flags
    illegal Hall states (0/7) or missing states before any
    calibration can fault on them.
    --setup-motors ODrive 0.5.x hoverboard-guide values for both axes:
    pole pairs, Hall mode, cpr 6*pp, calib voltage/range,
    torque constant 8.27/KV, velocity gains scaled by it,
    current limit 15 A, vel limit 10 turns/s. Saves.
    --calibrate motor c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
2026-10-20 odrive-check: prove the save and the reboot instead of assuming them
    On 2026-10-19 the ODESC reported factory bus limits (inf A, 8 V, 60 V)
    although --apply had printed 'applied and verified.' on 10-11. It called
    save_configuration() without looking at the result, swallowed the
    reboot's exception, and re-read the settings - which come from RAM on a
    board that may not have saved or rebooted at all.
    _save_and_reboot() now fails loudly if save_configuration() returns
    False, and accepts the reboot only if system_stats.uptime went back
    down; otherwise it says the read-back would be from RAM. Used by --apply,
    --setup-motors and --calibrate, the last of which now also reads
    pre_calibrated back fro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
2026-10-20 odrive-check: the save/reboot check, actually this time
    5b12a45 describes _save_and_reboot() but its tree does not contain it:
    the file copied to the Mac before that commit was a stale version (the
    bring-up from 4396d10, whose own commit had recorded no change to this
    file). Verified by checksum against the tested copy before committing.
    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
2026-10-20 odrive-check --calibrate: skip unsupported Hall polarity; explain resistance faults
    From the first calibration, 2026-10-19:
    - axis0 passed motor calibration, then the Hall polarity step failed
    with AXIS_ERROR_INVALID_STATE: the python package (0.5.4) knows that
    state, firmware 0.5.1 does not. It is now optional - skipped when the
    board rejects it - and offset calibration runs as before.
    - axis1 failed motor calibration with MOTOR_FAILED /
    PHASE_RESISTANCE_OUT_OF_RANGE. The measured phase R and L are now
    printed after every motor calibration, with the limit implied by the
    test current and voltage, so an open connection (huge R) is told apart
    from a motor just over the limit.
    - e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
2026-10-20 Base: M0/axis0 is the RIGHT wheel, M1/axis1 the LEFT
    Mounted with M0 toward the cart's right, each motor wires straight to its
    own side with no crossover. odrive_base picks the axes from RIGHT_AXIS /
    LEFT_AXIS; odrive-check labels them from the same mapping; docs updated.
    Invert flags unchanged - settle them with odrive-check --spin.
    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
2026-10-22 odrive-check --halls: say so when an axis sees no movement; never suggest 0 pole pairs
    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
2026-10-22 odrive-check --calibrate: --cal-max-voltage to tell a loose phase from a high-resistance motor
    Also: say 'not measured' instead of 0 mOhm on a failed resistance test, and
    fix the --axis help (0 = right, 1 = left).
    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
2026-10-22 odrive-check --setup-motors: resistance_calib_max_voltage 6 V
    The hub motors measure 365 (right) and 412 (left) mOhm per phase; at 4 V /
    10 A the limit is 400 and the left wheel fails calibration.
    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
2026-10-22 cart-remote.yaml: wheel radius confirmed (6.5 in hub wheel); wheelbase still a placeholder
    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
2026-10-22 cart-remote.yaml: wheelbase 0.527 m (measured)
    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
2026-10-22 cart-selftest --base: average over 0.8 s, ODrive at Hall-friendly speeds, per-wheel readout
    0.08 m/s is ~14 Hall edges/s on the hub wheels; five reads in 30 ms caught
    single instants of a jittery estimate (forward +66%, backward read positive).
    Now 0.2 m/s / 45 deg/s on the ODrive base, mean of the last 0.8 s with its
    range, WARN outside 0.7-1.3x, and each wheel's raw turns/s.
    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
2026-10-22 elroy camera rule: wrist cameras now on hub ports 2.1.3 (left) / 2.1.1 (right)
    The hub moved during the base wiring; left identified by unplugging it.
    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
2026-10-22 cart-teleop: video to the Mac viewer by default, if it is running
    No flag = --watch when the viewer answers on WATCH_HOST:WATCH_PORT, no video
    (with a note) when it doesn't, so rerun is never pointed at nothing - that
    back-pressures into the control loop. --no-watch turns it off; an explicit
    --watch keeps the old behaviour. cart-record.sh unchanged (opt-in).
    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
2026-10-22 odrive-check --push: both wheels on the floor, logging which limit stops the cart
    For 'cannot get over the carpet': per-wheel speed and motor current, pack
    current, vbus and the velocity integrator every 0.2 s, then which limit was
    hit - motor current_lim, the pack-current limit (a fault on 0.5.1), or
    neither (the speed controller's gains).
    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
2026-10-22 odrive-check: --vel-gain/--int-gain to try gains in --spin/--push, --save-gains to keep
    --push on the floor (2026-10-22): stalled at the carpet edge, motor current
    only reached 9.4 of 15 A and pack 2.9 of 10 A in 1.8 s of stall - the
    integrator builds ~1.8 Nm/s at the hoverboard-guide gains (vel_gain 0.93).
    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
2026-10-22 odrive-check --setup-motors: write the tuned vel_gain 8 (integrator 40)
    Saved on the board by Carl 2026-10-22; a re-setup would otherwise put back
    the hoverboard-guide 0.93 that stalled the cart at the carpet edge.
    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
2026-10-22 ODrive base: acceleration ramp on the board (max_accel_mps2, default 1.0)
    At vel_gain 8 (needed for the carpet edge) teleop's tick-to-tick velocity
    steps became torque spikes and the cart jerked, while --push at a constant
    command was smooth. INPUT_MODE_VEL_RAMP with vel_ramp_rate = accel /
    circumference smooths the command without softening load rejection. Stops
    ramp too (0.5 s from 0.5 m/s). 0 = passthrough as before.
    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
2026-10-22 odrive-check: --enc-bw to try/save the encoder bandwidth; --spin reports steady-state current
    At vel_gain 8 the unloaded wheel drew up to 14.2 A on blocks (2.2 A at the
    guide gains): the controller amplifying Hall velocity-estimate noise, which
    is the jerk in teleop. Steady current on blocks is the metric to tune by.
    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
2026-10-22 odrive-check --push: per-wheel speed ripple and current over the second half
    To compare gains by number on an open floor, where the cart's inertia is
    on the wheels - blocks are a different plant.
    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
2026-10-23 ODrive base: LEROBOT_BASE_TRACE=1 prints command vs wheel response every 0.2 s
    Teleop drives slow and jerky where odrive-check --push at the same gains
    and speed was smooth; this shows what teleop actually asked the wheels for.
    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
2026-10-23 ODrive base trace: write to base-trace.log, not the terminal
    teleop's status line moves the cursor up and overwrote the trace lines.
    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
2026-10-23 Base: first-principles characterization and tuning; feed-forward in odrive_base
    config/base-characterize.sh blocks|floor|design|step:
    blocks motor constant from back-EMF, wheel inertia and drag (spin-up/coast)
    floor breakaway, cart inertia and rolling friction (two torque levels),
    friction and speed-estimate noise vs speed, optional bandwidth sweep
    design current limit from the pack fault limit, soft/medium/stiff PI
    candidates from the measured inertia (wc = wb/4, Ki = Kp wc/4),
    friction + inertia feed-forward, accel and speed limits
    step the candidates through ODriveBase at 30 Hz like teleop; rise,
    overshoot, ripple, current jitter, sto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
2026-10-23 base-characterize design: --mass-kg (7.5 kg, weighed) cross-checks the torque constant
    Inertia is measured in ODrive units, so the mass it implies scales with true
    kt / configured kt: a scale reading measures kt independently of the
    back-EMF test, and a disagreement points at Hall commutation. Also splits
    friction into motor drag (blocks coast-down) and floor/caster rolling
    resistance, and estimates the traction limit - on a 7.5 kg cart, grip, not
    current, caps obstacle force.
    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
2026-10-24 Base: measured torque constants (0.340 / 0.363 Nm/A, KV ~23.5) and the tools to set them
    base-characterize blocks read the back-EMF correctly but rejected it on its
    sign (Vq and Iq both read negative for positive speed on this board): use
    the magnitude, and check the line passes through zero instead. Both motors:
    clean straight lines, intercept < 0.1 V - KV 24.3 / 22.8, not 16. The board's
    0.517 Nm/A overstated torque per amp by ~45%.
    odrive-check --save-gains --kt R,L sets the constants; without --vel-gain it
    rescales the gains with them so the wheels behave identically.
    --setup-motors: per-axis MEASURED_KT unless --kv; gains 2.7 / 8.5 at encoder
    bandwidth 50 (the 7.5 kg model's medium can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
2026-10-24 odrive-check --hall-noise; base-characterize arm retries and explains OVERSPEED
    Left axis failed to arm for the floor stage with controller OVERSPEED (and
    the knock-on motor CONTROL_DEADLINE_MISSED) at a standstill, config normal:
    a speed-estimate spike, i.e. Hall noise or a loose Hall contact.
    --hall-noise watches both still wheels' counts for jumps and illegal states
    while the wires are wiggled. Controller errors now have names.
    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
2026-10-24 base-characterize: reboot the board at the end of every stage
    A second floor run in one power-up failed to arm axis1 with OVERSPEED at a
    standstill; a power cycle cleared it. Restoring the settings is not enough -
    some state survives the torque/velocity/ramp mode switching. Nothing is ever
    saved to flash here, so a reboot restores exactly the saved configuration and
    also drops trial gains.
    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
2026-10-24 base-characterize: cart inertia from the scale mass; gentler floor pushes
    The floor torque steps (up to 2x breakaway) made the wheels slip on carpet:
    the cart is light and tilted back onto its casters. A slipping wheel reads
    as a lighter cart. With --mass-kg (default 7.5) and the back-EMF constant
    from blocks, design now computes the inertia from mass + wheel inertia and
    only checks the floor value against it (low = slip, high = heavier than
    weighed or poor commutation). Floor push levels 1.15x / 1.5x breakaway.
    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
2026-10-25 Base model: cart is 17.2 kg (38 lb, complete, new casters), not 7.5
    Per-wheel inertia 0.42 (cart 0.37 + wheel 0.05, real units); medium
    candidate 5.2 / 16.3 at encoder bandwidth 50 is what --setup-motors writes.
    At this mass the earlier inconsistencies go away: the carpet-edge stall was
    ~0.40 of the weight in push, and floor+caster rolling resistance ~0.05.
    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
2026-10-25 base-characterize blocks: back-EMF at gentle gains, 5 speeds, fit quality
    At vel_gain 5.2 (right for the floor, ~9x livelier on blocks) the left
    motor's back-EMF read 0.311 on a crooked line (-0.28 V intercept) against a
    clean 0.363 at the earlier, gentler gains. The constant is now measured at
    vel_gain 0.6 / integrator 1.5 (RAM; the reboot restores the saved gains), at
    5 speeds with longer averaging, and the rms residual is reported; a crooked
    fit no longer prompts changing the constant.
    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
2026-10-25 Measured torque constants 0.371 / 0.379 Nm/A (clean back-EMF fit)
    Gentle-gain, five-speed back-EMF on both motors: rms residual 0.003 V,
    intercepts within 0.03 V of zero. Supersedes 0.340 / 0.363 from three noisier
    points. Wheel inertia and drag repeated within 3%.
    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
2026-10-25 base-characterize: current sign, Stribeck friction, --ff-basis floor|motor
    Floor run 2026-10-25 (rug, new casters): friction came out negative - Iq
    reads negative for positive torque on this board. floor now learns the sign
    during the breakaway ramp; design uses magnitudes, so the stored run is
    usable as is. Friction falls with speed (1.00 Nm at 0.1 m/s -> 0.77 from 0.3):
    the feed-forward is sized on the lowest value so it never pushes. --ff-basis
    motor sizes it on the motors' own drag (0.40 of the 0.77 on the rug) for a
    cart that also drives on hard floors. Inertia push levels clear the low-
    speed friction (the 1.12 Nm level never got up to speed); single-push check.
    step prints current mag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
2026-10-25 base-characterize design: stall line uses the chosen feed-forward
    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
2026-10-25 Base tuned: feed-forward 0.36 / 0.419, 1.0 m/s, 0.6 m/s at full stick
    base-characterize step --candidates on rug and hardwood (2026-10-25): medium
    (5.2 / 16.3, bandwidth 50 - already saved on the board) wins both. Hardwood:
    4% ripple at 0.15-0.3 m/s, 0.26 s to speed, no surge with the motor-only
    friction feed-forward; rug: 7%, 0.6 s. Crawl (0.05 m/s) is rough on every
    setting - the Hall resolution, not the tuning.
    cart-remote.yaml: friction_ff_nm 0.36, inertia_ff 0.419, max_linear_mps 1.0,
    max_accel_mps2 1.0. operator-leader-host.yaml: base_speed_mps 0.6.
    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
2026-10-25 ODrive base: arm the board's watchdog while driving (0.5 s)
    2026-10-25: a wrist camera dropped mid-teleop and the cart reached a wall;
    the base stopped ~1 s after the camera failed, via the teleop cleanup. The
    board's watchdog was off ('the robot loop is the watchdog'), so a stalled or
    killed process would have left the wheels driving indefinitely.
    Now armed on the first command (so the connect-to-first-tick gap cannot trip
    it), fed on every read and command (at most every 50 ms), fed again on
    re-arm, disarmed on disconnect. Expiry drops the axes to IDLE: the wheels
    coast, motor drag stops the cart. odrive_watchdog_s in the config (0 = off).
    odrive-check disarms it on connect, in case a rob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
2026-10-25 ODrive: name the DC-bus fault bits; connect error says what they mean
    After the wall impact both axes refused closed loop with 0x30 =
    BRAKE_RESISTOR_DISARMED | MOTOR_DISARMED: a latched DC-bus fault that only
    a power cycle clears. The connect error used to say 'needs encoder
    calibration' for any error.
    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
2026-10-25 ODrive base: log every held error word before clearing; refuse a disarmed brake resistor
    fw 0.5.1 keeps no board-level error log, and connect/re-arm cleared the
    axis errors first - so the cause of the 2026-10-25 DC-bus fault (after the
    wall impact) was erased by the next connect. Now: all axis/motor/encoder/
    controller words and brake_resistor_armed are logged before any clear, on
    connect and on every re-arm; connect refuses straight away, saying a power
    cycle is needed, if the brake resistor is disarmed.
    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
2026-10-27 Wifi power saving off on elroy and rosie: setup step and symptom row
    NetworkManager enables wifi power saving by default on both the Orin and
    the Pi. With it on, elroy's 540 Mbit/s 5 GHz link measured 10 Mbit/s with
    whole seconds of nothing; the viewer ran 9-11 s behind on every camera and
    the leader link stalled ~300 ms about once a second. Turning it off removed
    the dead seconds. The link still measured 3-20 Mbit/s afterwards, so the
    radio link itself is the next suspect.
    ORIN-SETUP.md: the commands for both machines (iw now, nmcli for every
    boot). README.md: a prerequisite. RUNNING.md: the symptom row.
2026-10-27 elroy wifi: turn off the rtl8822ce driver's own power saving
    With iw/NetworkManager power save already off, elroy still measured
    3-20 Mbit/s to the Mac at -57 dBm, while rosie through the same access
    point did 175. JetPack's out-of-tree rtl8822ce driver has its own power
    management underneath iw: rtw_power_mgnt=2 and rtw_ips_mode=1. Both are
    load-time options, so /etc/modprobe.d/rtl8822ce-nopowersave.conf sets
    them to 0 and the Orin reboots. After: 108 Mbit/s, six retransmissions in
    ten seconds, video keeps up in the viewer.
    ORIN-SETUP.md: the driver step, its check, and the remaining one-stream
    tx note. RUNNING.md: the symptom row checks rtw_power_mgnt too.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
2026-11-01 Right arm bus board is now 5B91028673
    The right follower's board (bus 2) was replaced; 5A68009991 is off the
    cart. Point every port2 reference at the new board's by-id path.
